north90/OpenSampler/Assembly_instructions/images/electronics_parts.jpg

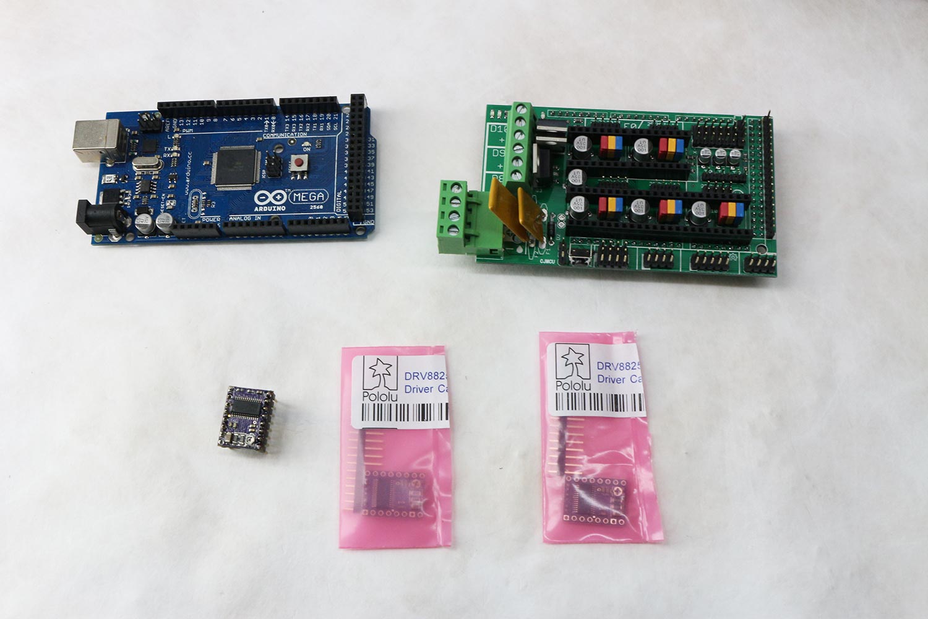
Assembly_instructions/images/electronics_parts.jpg
