north90/OpenSampler/README.md

OpenSampler
===========

Open Source Autosampler for use in laboratory analysis
