north90/OpenSampler/Software/Firmware_Arduino_mega/_20151002_Opensampler_V5_Sprinter/README.txt

Open and edit with arduino version 0.22 or 0.23
