north90/OpenSampler/Assembly_instructions/images/electronics_mounted.jpg

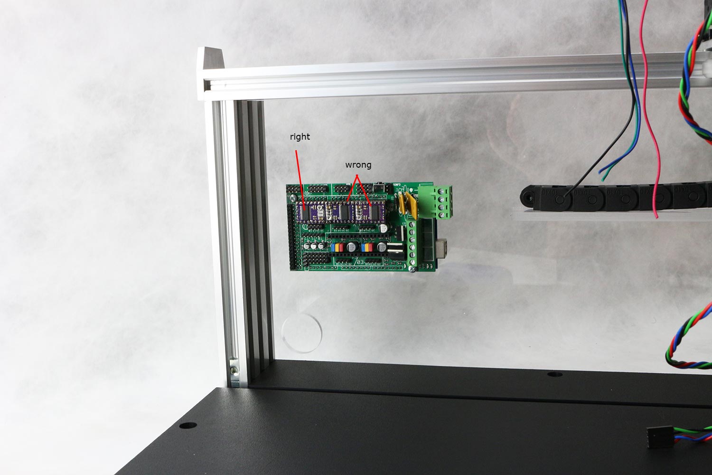
Assembly_instructions/images/electronics_mounted.jpg
