north90/OpenSampler/Photos/IMG_8499_small.jpg

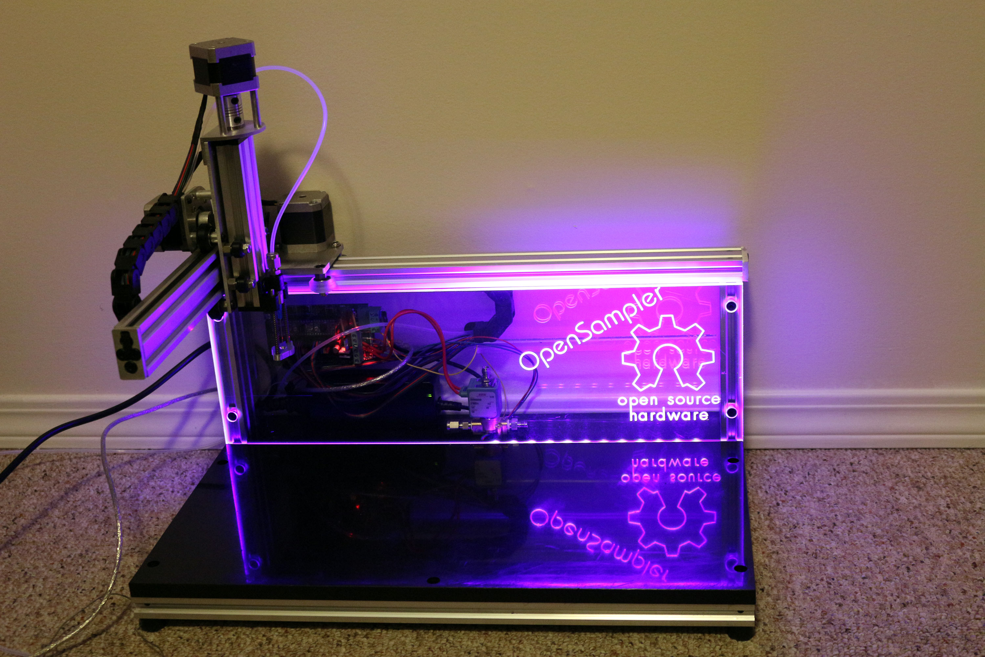
Photos/IMG_8499_small.jpg
