north90/OpenSampler/Photos/IMG_8510_small.jpg

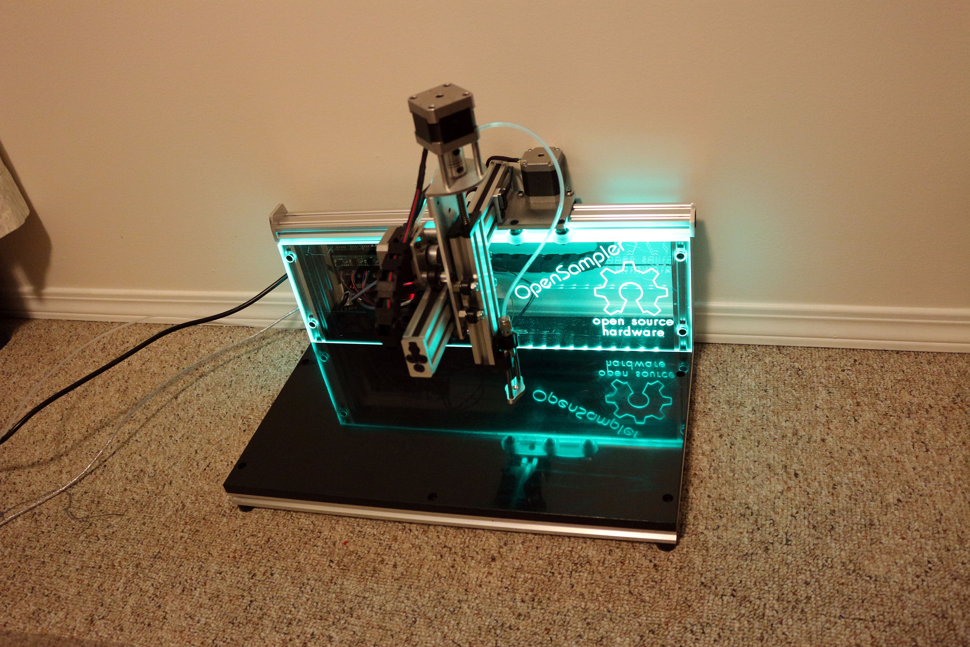
Photos/IMG_8510_small.jpg
