north90/OpenSampler/Photos/IMG_8513_small.jpg

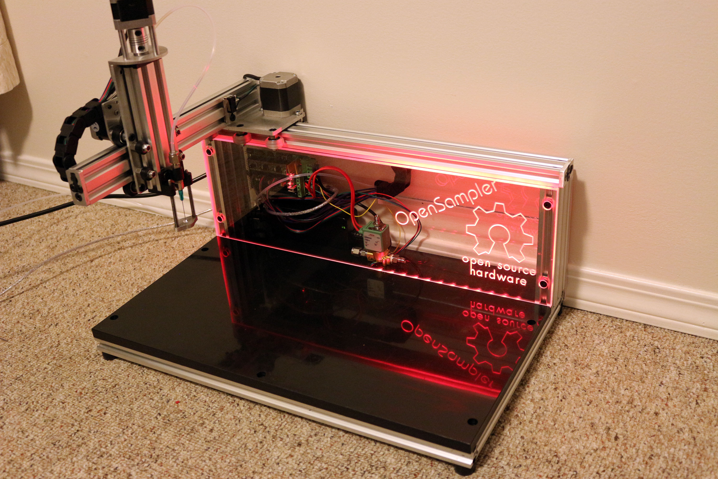
Photos/IMG_8513_small.jpg
