north90/OpenSampler/Required_parts_and_sources/README_OPENSAMPLER_PARTS.txt

In this folder there are printouts of shopping carts.
NOT all parts are needed in the QUANTITIES in the lists.
These lists are NOT 100% complete, but cover almost all parts.
These parts can be obtained at other sources that might be more economical.
