north90/OpenSampler/Required_parts_and_sources/20150505_mcmaster_partlist.pdf

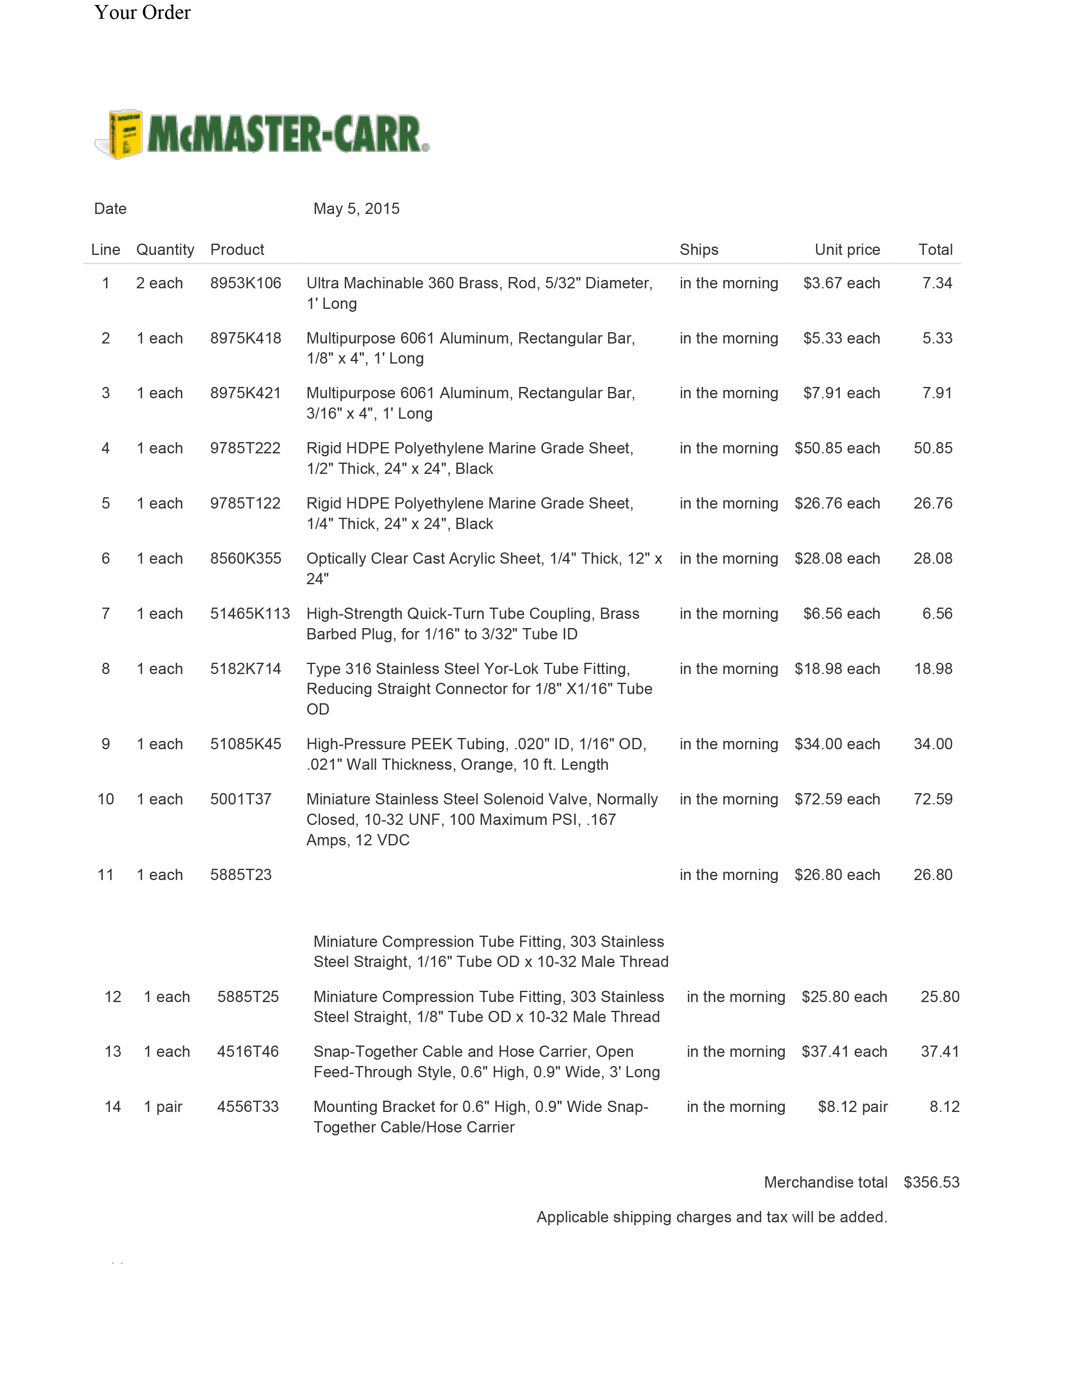
[picture p7: page 1]
