north90/OpenSampler/Required_parts_and_sources/20150505_openbuilds_partlist.pdf

sssttssstssststss sssstsssts ssssstststts tttttttttt

)ss)tssstt)))tsts)s) ss tttttt

et)s | eeetessesttstes s | tttstsstttst tssst

# tttstsstttst tssstt

sstttttsttsttsttttstsstttst ttssttssest ssttttsstsset

sssttsts)s | ytt | sts)tessts | sts)t ttsl

)sltttsstssst-

ssl
ss s t | ))tt t | )t)t
sst tts t ) | )t)t
ssst st
| s)test
) e | t | 4e)4

)sltttsstssst-

ssl
ss s t | ))tt t4 )t)t
sst tts t ) | )t)t
ssst st

)
s)test
) e) t | ) e)

)sltttsstssst-

ssl
ss s t | ))tt t) )t)t
sst tts t | ))t
ssst st

)
s)test
e | t | e
tss)ststlsst)tssssltst | )

s)test

e) t | )e )
slsstttstst)tssssltst | )

s)test

e | t | e
s | t) )))ttlt)stt)t s)st tetllsttht)4t ttts

s)test

)e | t | ) e
s | t ))t s)st ttslt | e | t | ) e
st tttsl | 4)e )

xsts)ststsssttst txt s

ssstst ttsl | 4)e )

## stsssttttsttesstss

ssttsststttssstttt slt)t
tttssstlstttststttttsstsststt tsstsslsttsstttsssttte

yssstlttstsssttt

ts sttsts

ttstsslss

tss sl

sstsss

xtst

ste

nstst

ds)tdsslsts

sst sttss

s)st sslsts

## ssss)tssstt ssstssststs

tttsttststtsssttssssttsst t st sstttsstssststs tsttssttsst sstttsstssstststttsststttsst t t slt)tststtlst.t.st.e

stt lstsxststss | t
et)s | tlt | msssssssstest ss) | mty | sexdtsssystestsstts
- t | t | 1 | 3
t | e// | - p | p pppp p pp p pp p/p p t | //////5/1/

sssttsts)s | ytt | sts)tessts | sts)t ttsl
| 4
| s)test

sttsst.st
ss s t sst ltst
ssst st

s)test

)e )t | e)

tlt)stt)tststsss
ss s t ) 4 t
ssst st

)
s)test
e 4t | e

xttsttssttststss
sst tts t ) 4 t
ssst st

s)test

e4)t | )e

st)testsslststss)stt
sst tts t )) t tettst
ssst st

)
s)test
)e | t | )e

st)testsslststss)stt
sst tts t ) )) t tettst
ssst st

s)test

e4 t | ) e )
dtttelstststst ))ttstsstttt)stsssststss) | )

s)test

e 4t | e 4
sstdttst) | test.)
ss s t t t
ssst st

s)test

e | t | ))e
st tttsl | 4)e )

xsts)ststsssttst txt s

ssstst ttsl | 4)e )
- t | t | 5 | 3

hhttsthh
tsst.ttttt)stst)tltstlstsssssssss

slst.tsssstttt.ssttsstttst t

sssttsts)s | ytt | sts)tessts | sts)t ttsl

st)testsslststss)stt
sst tts t )) t) tettst
ssst st
| )
| s)test
e | t | e
stt.sttessststss)stt t) | test.)
sst tts t )))t
ssst st

)
s)test
e4)t | e4)
stt.sttessststss)stt t) | test.)
sst tts t | ))t
ssst st

)
s)test
e4)t | e4)

tllsttssstts
ss s t ))t
ssst st

s)test

e )t | e
st tttsl | 4)e )

xsts)ststsssttst txt s

ssstst ttsl | 4)e )

# sttttttstss

sstttttsseststtttttttttss tsttsststtstttsst t t slt)tststtlst.t.st.e

tttstmsssttds)s | tttstx)sslttssssss

# ststtds)slsttss

ststttslsstst

# ststttstsstss

ststttslsststsstest!

)hslttt4 ))t t4 ))

ststttslsstesstst ssttsts

tttsst tststslstttttts!

shtss)t slssss

tllttsstsstssststtstytstttss stt | ) tststttslsstessttsttssetssts)stt tessestttetlstt
- t | t | 3 | 3
