north90/OpenSampler/Assembly_instructions/images/frame_parts.jpg

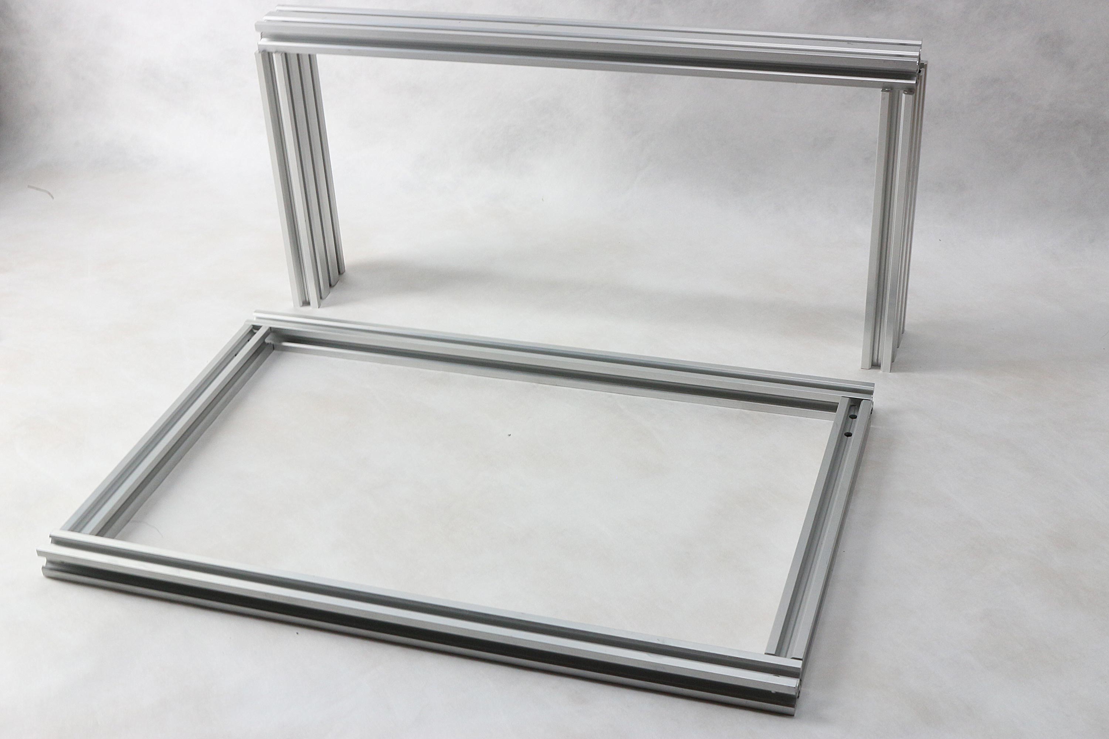
Assembly_instructions/images/frame_parts.jpg
