north90/OpenSampler/Assembly_instructions/images/y_endstop_parts.jpg

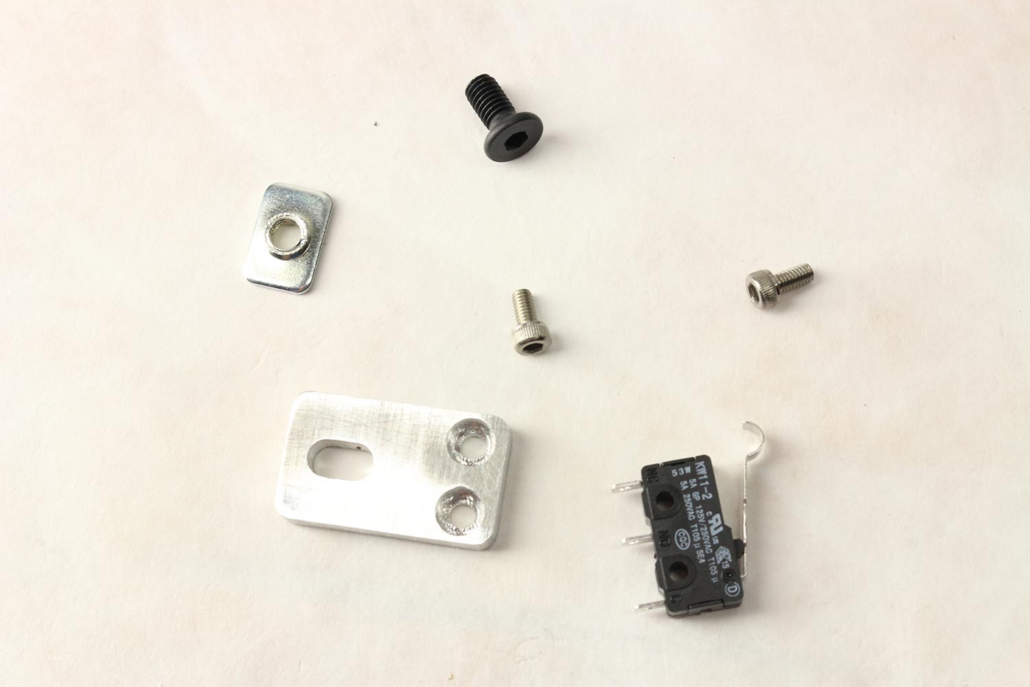
Assembly_instructions/images/y_endstop_parts.jpg
