north90/OpenSampler/Assembly_instructions/images/z_parts.jpg

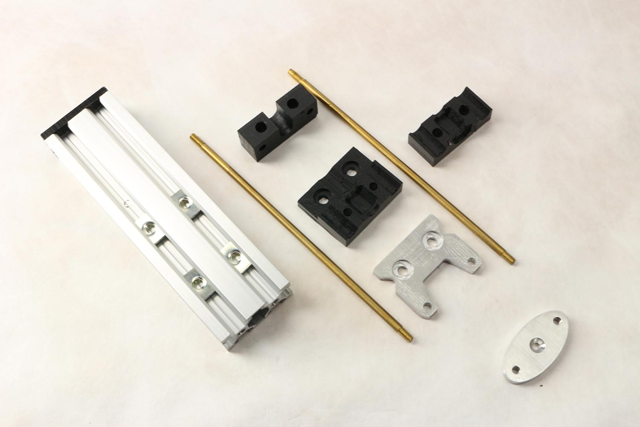
Assembly_instructions/images/z_parts.jpg
