north90/OpenSampler/Mechanical_design/INDIVIDUAL_PARTS_2D/20150915_3X_16mm_40tube_tray_v0p0.dxf

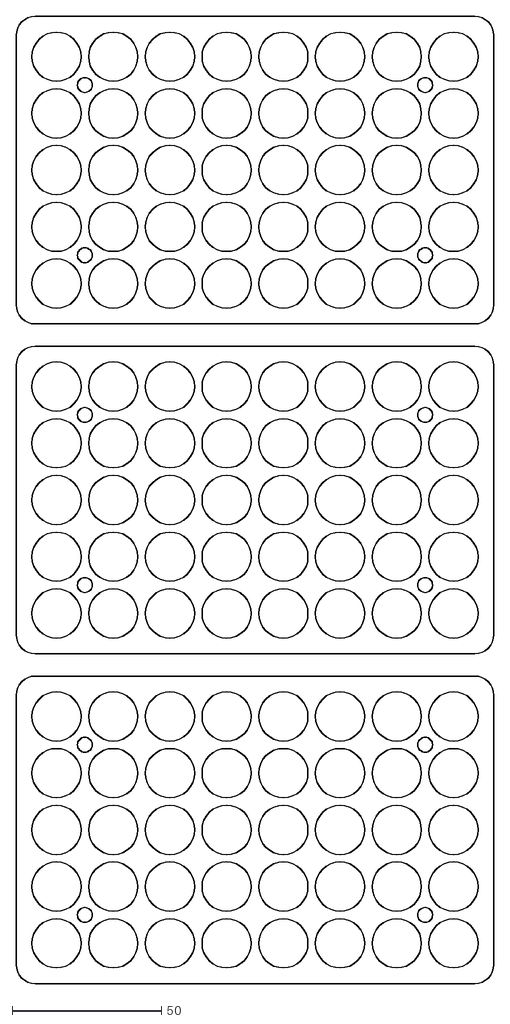
[picture p11: CAD file, 2017-06-14]
Mechanical_design/INDIVIDUAL_PARTS_2D/20150915_3X_16mm_40tube_tray_v0p0.dxf
160.0 x 324.0
