north90/OpenSampler/Mechanical_design/INDIVIDUAL_PARTS_2D/20150915_HDPE_backplate.dxf

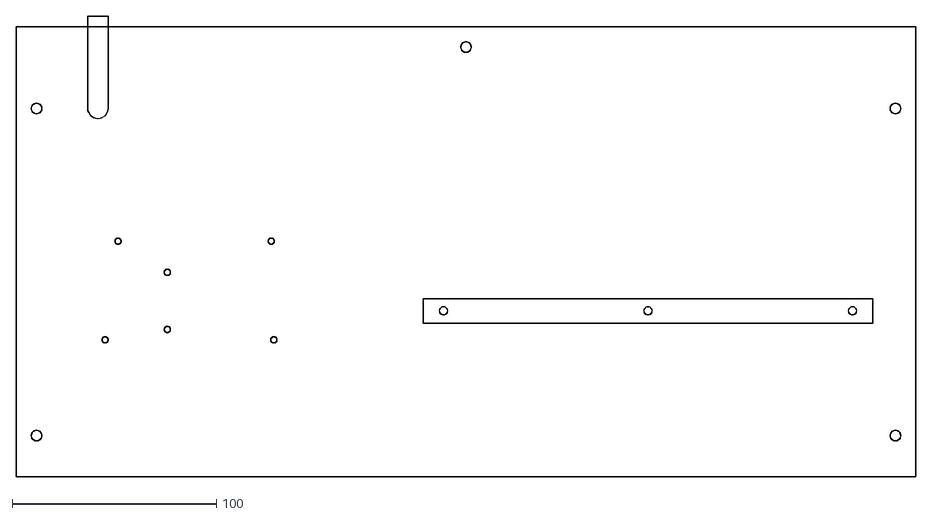
[picture p12: CAD file, 2017-06-14]
Mechanical_design/INDIVIDUAL_PARTS_2D/20150915_HDPE_backplate.dxf
440.0 x 225.0
