north90/OpenSampler/Mechanical_design/INDIVIDUAL_PARTS_2D/20150609_spring_plate.dxf

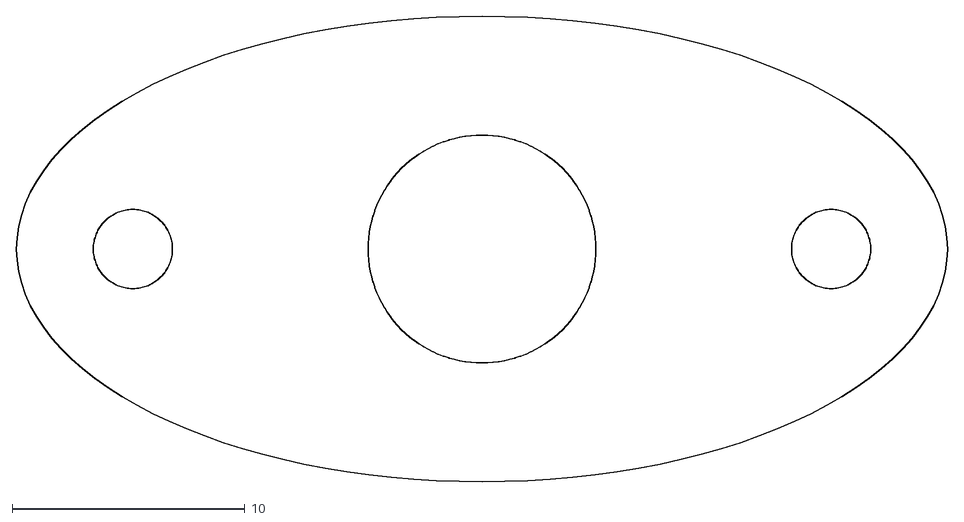
[picture p13: CAD file, 2017-06-14]
Mechanical_design/INDIVIDUAL_PARTS_2D/20150609_spring_plate.dxf
40.0 x 20.0
