north90/OpenSampler/Mechanical_design/INDIVIDUAL_PARTS_2D/20150609_spring_support_plate_bottom.dxf

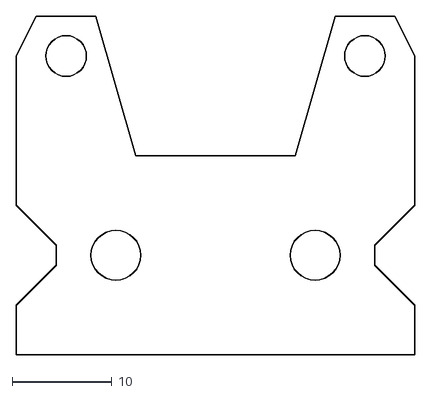
[picture p14: CAD file, 2017-06-14]
Mechanical_design/INDIVIDUAL_PARTS_2D/20150609_spring_support_plate_bottom.dxf
40.0 x 34.0
