north90/OpenSampler/Mechanical_design/INDIVIDUAL_PARTS_2D/20150602_frontplate.dxf

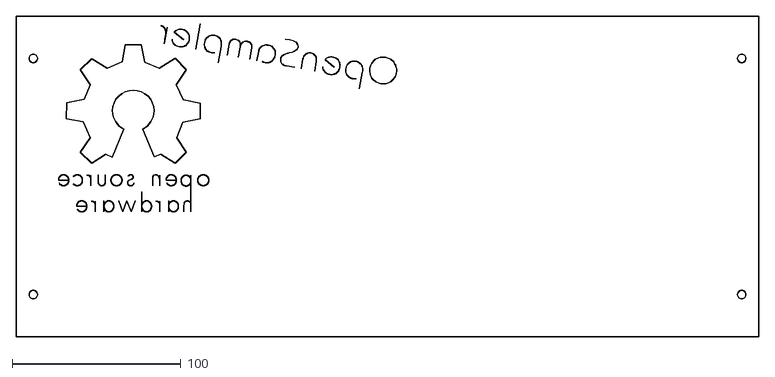
[picture p15: CAD file, 2017-06-14]
Mechanical_design/INDIVIDUAL_PARTS_2D/20150602_frontplate.dxf
440.0 x 190.0
