north90/OpenSampler/Mechanical_design/INDIVIDUAL_PARTS_2D/20150610_z_motor_plate_ACME_top-cut.dxf

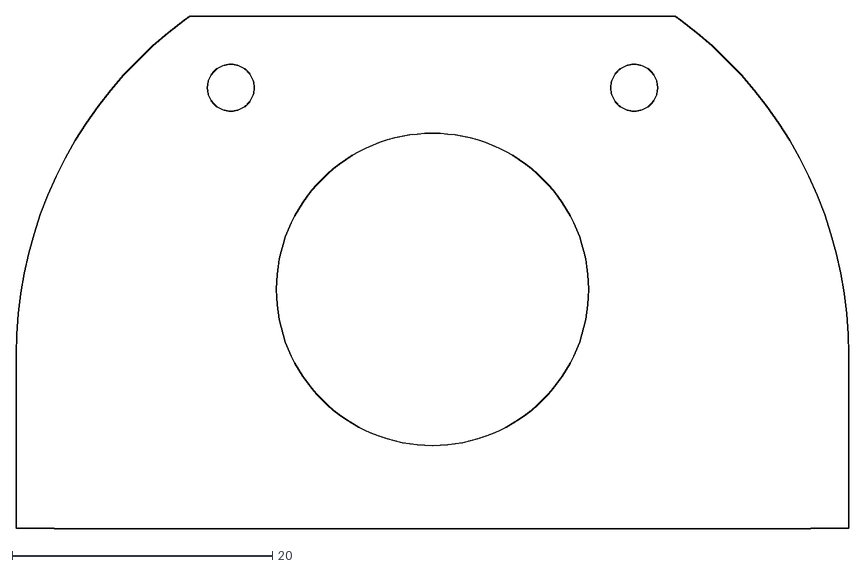
[picture p16: CAD file, 2017-06-14]
Mechanical_design/INDIVIDUAL_PARTS_2D/20150610_z_motor_plate_ACME_top-cut.dxf
64.0 x 39.4
