north90/OpenSampler/Mechanical_design/INDIVIDUAL_PARTS_2D/20150608_y_plate_top.dxf

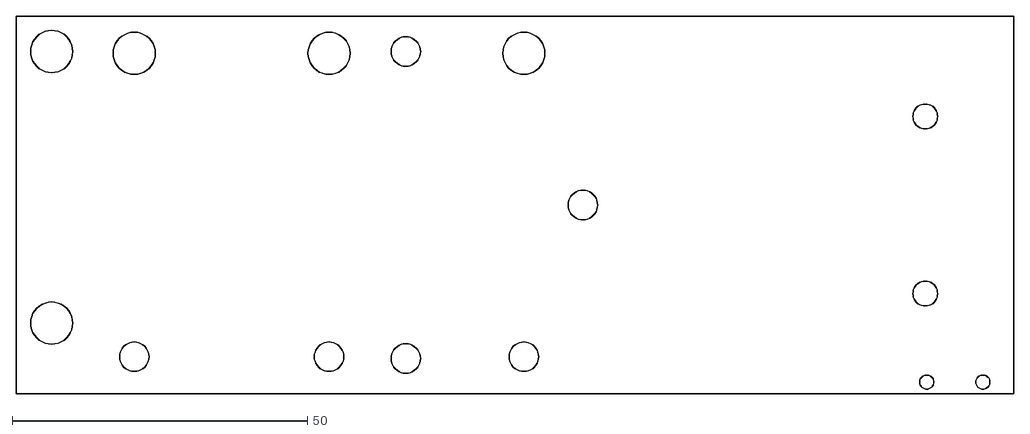
[picture p17: CAD file, 2017-06-14]
Mechanical_design/INDIVIDUAL_PARTS_2D/20150608_y_plate_top.dxf
169.0 x 64.0
