north90/OpenSampler/Mechanical_design/INDIVIDUAL_PARTS_2D/20150609_needle_mount_bottom.stl

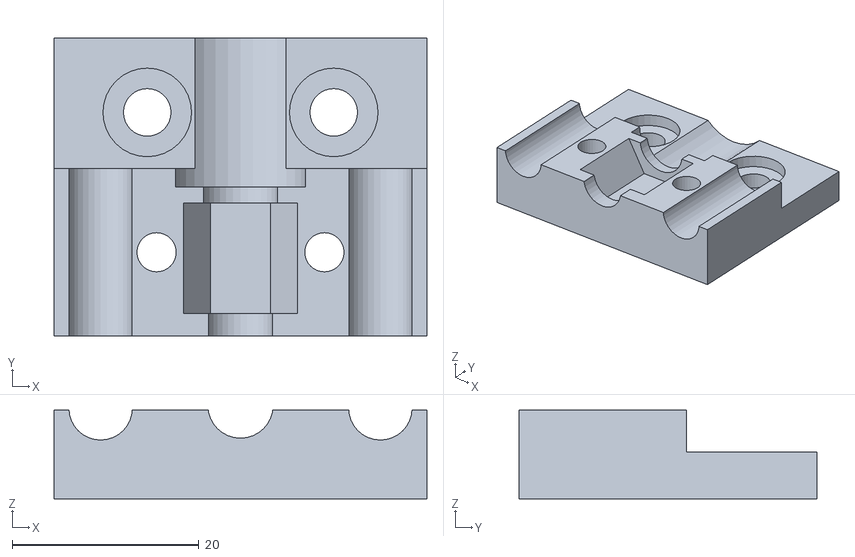
[picture p18: CAD file, 2017-06-14]
Mechanical_design/INDIVIDUAL_PARTS_2D/20150609_needle_mount_bottom.stl
40.0 x 32.0 x 9.50
