north90/OpenSampler/Mechanical_design/INDIVIDUAL_PARTS_2D/20150917_solenoid_plate_5mm.dxf

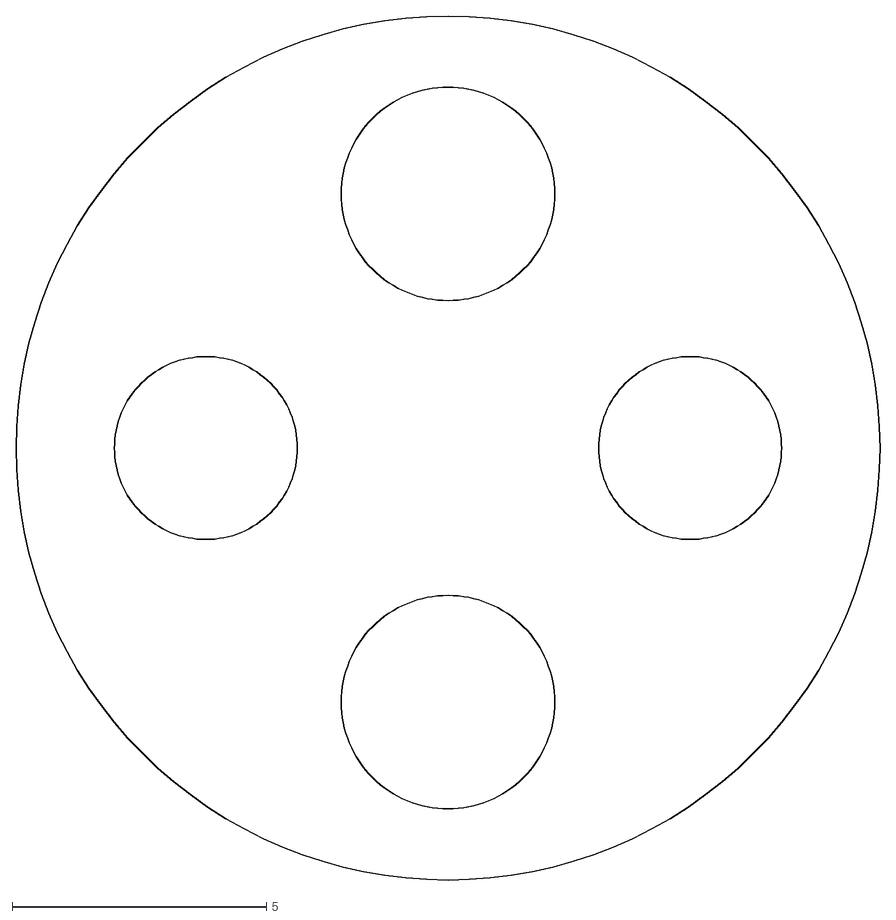
[picture p19: CAD file, 2017-06-14]
Mechanical_design/INDIVIDUAL_PARTS_2D/20150917_solenoid_plate_5mm.dxf
17.0 x 17.0
