north90/OpenSampler/Mechanical_design/INDIVIDUAL_PARTS_2D/20150609_needle_mount_top.stl

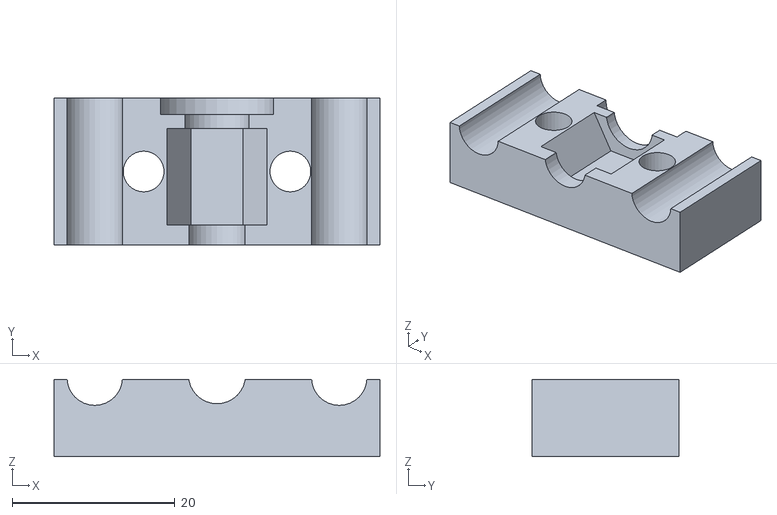
[picture p20: CAD file, 2017-06-14]
Mechanical_design/INDIVIDUAL_PARTS_2D/20150609_needle_mount_top.stl
40.0 x 18.0 x 9.50
