north90/OpenSampler/Mechanical_design/INDIVIDUAL_PARTS_2D/20150706_x_cart.dxf

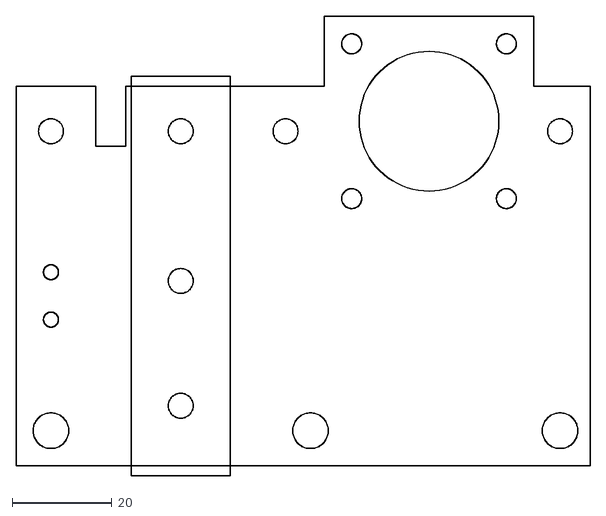
[picture p21: CAD file, 2017-06-14]
Mechanical_design/INDIVIDUAL_PARTS_2D/20150706_x_cart.dxf
115.0 x 92.0
