north90/OpenSampler/Mechanical_design/INDIVIDUAL_PARTS_2D/20150706_1x2_belt_endplate.dxf

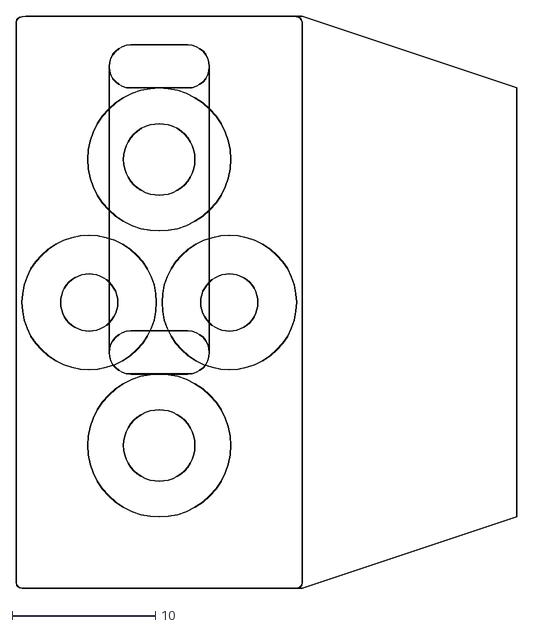
[picture p22: CAD file, 2017-06-14]
Mechanical_design/INDIVIDUAL_PARTS_2D/20150706_1x2_belt_endplate.dxf
35.0 x 40.0
