north90/OpenSampler/Mechanical_design/INDIVIDUAL_PARTS_2D/20150608_z_motor_plate_side-cut.dxf

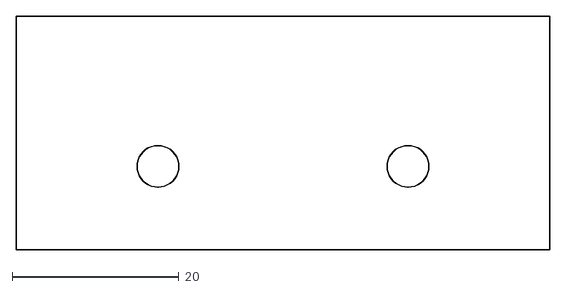
[picture p23: CAD file, 2017-06-14]
Mechanical_design/INDIVIDUAL_PARTS_2D/20150608_z_motor_plate_side-cut.dxf
64.0 x 28.0
