north90/OpenSampler/Mechanical_design/INDIVIDUAL_PARTS_2D/20150609_spring_support_plate_top.dxf

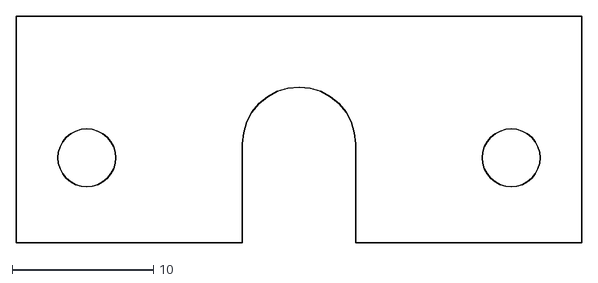
[picture p25: CAD file, 2017-06-14]
Mechanical_design/INDIVIDUAL_PARTS_2D/20150609_spring_support_plate_top.dxf
40.0 x 16.0
