north90/OpenSampler/Mechanical_design/INDIVIDUAL_PARTS_2D/20150608_z_motor_plate_top-cut.dxf

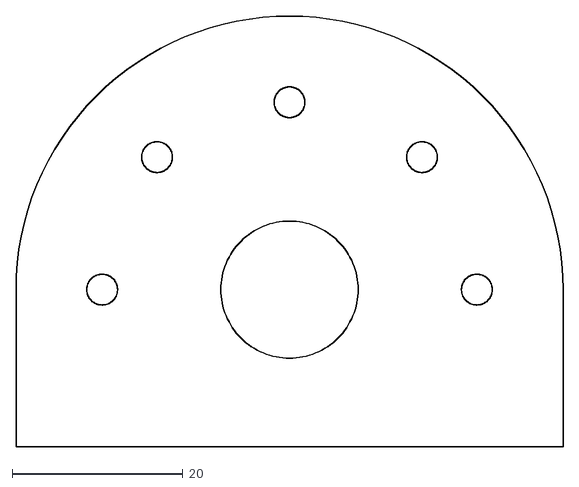
[picture p26: CAD file, 2017-06-14]
Mechanical_design/INDIVIDUAL_PARTS_2D/20150608_z_motor_plate_top-cut.dxf
64.0 x 50.4
