north90/OpenSampler/Mechanical_design/INDIVIDUAL_PARTS_2D/20150613_16mm_tube_tray_v0p0.dxf

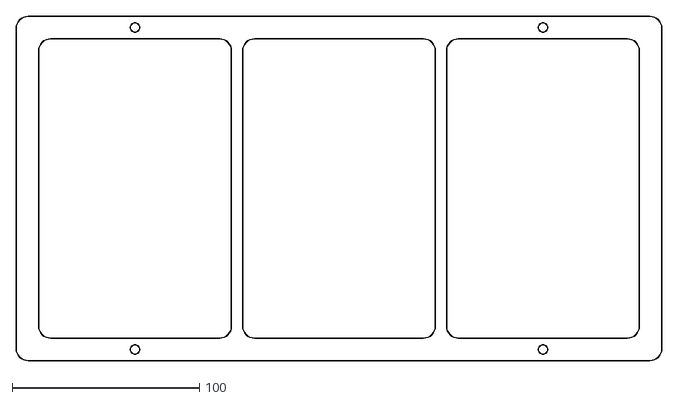
[picture p27: CAD file, 2017-06-14]
Mechanical_design/INDIVIDUAL_PARTS_2D/20150613_16mm_tube_tray_v0p0.dxf
345.0 x 184.0
