north90/OpenSampler/Mechanical_design/INDIVIDUAL_PARTS_2D/20150706_y_motor_plate.dxf

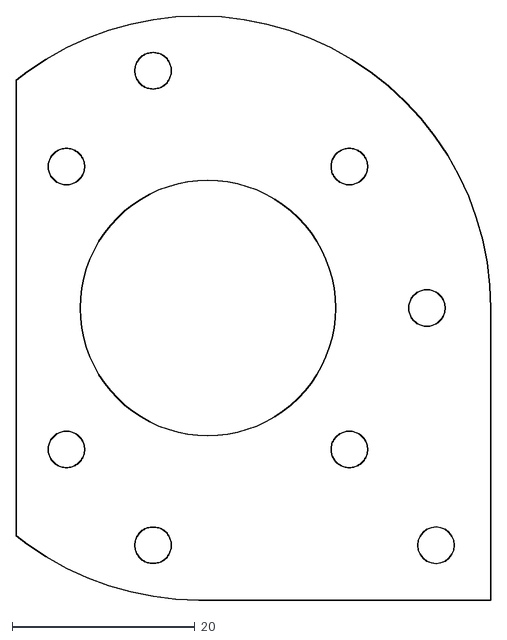
[picture p28: CAD file, 2017-06-14]
Mechanical_design/INDIVIDUAL_PARTS_2D/20150706_y_motor_plate.dxf
52.0 x 64.0
