north90/OpenSampler/(list of files, cad)

Other CAD files:
Mechanical_design/OpenSampler_v5_PARTS_v0p0.scad
Mechanical_design/OpenSampler_v5_v0p0.scad
Mechanical_design/INDIVIDUAL_PARTS_2D/20150613_16mm_tube_tray_v0p0.scad
Mechanical_design/INDIVIDUAL_PARTS_2D/20150610_z_motor_plate_ACME_side-cut.dxf
Mechanical_design/INDIVIDUAL_PARTS_2D/20150917_bottomplate_top.dxf
Mechanical_design/INDIVIDUAL_PARTS_2D/20150920_Y-endstop-plate_5mm.dxf
Mechanical_design/OpenSampler_v4_config_v0p0.scad
