north90/OpenSampler/Assembly_instructions/images/back_plate.jpg

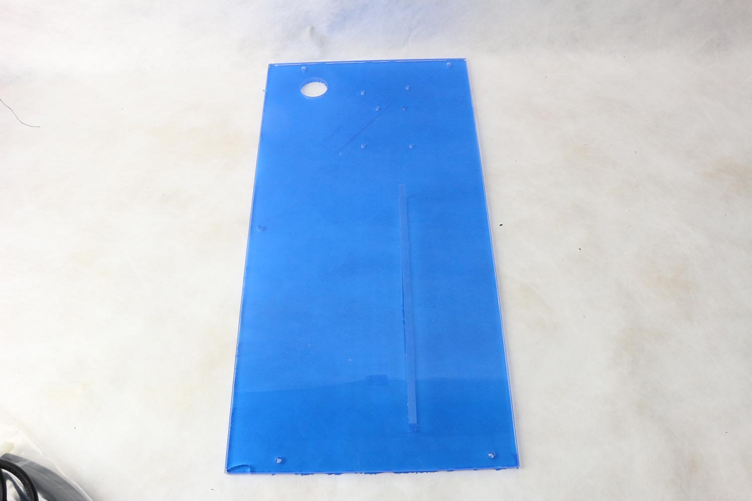
Assembly_instructions/images/back_plate.jpg
