north90/OpenSampler/Assembly_instructions/images/base_plate.jpg

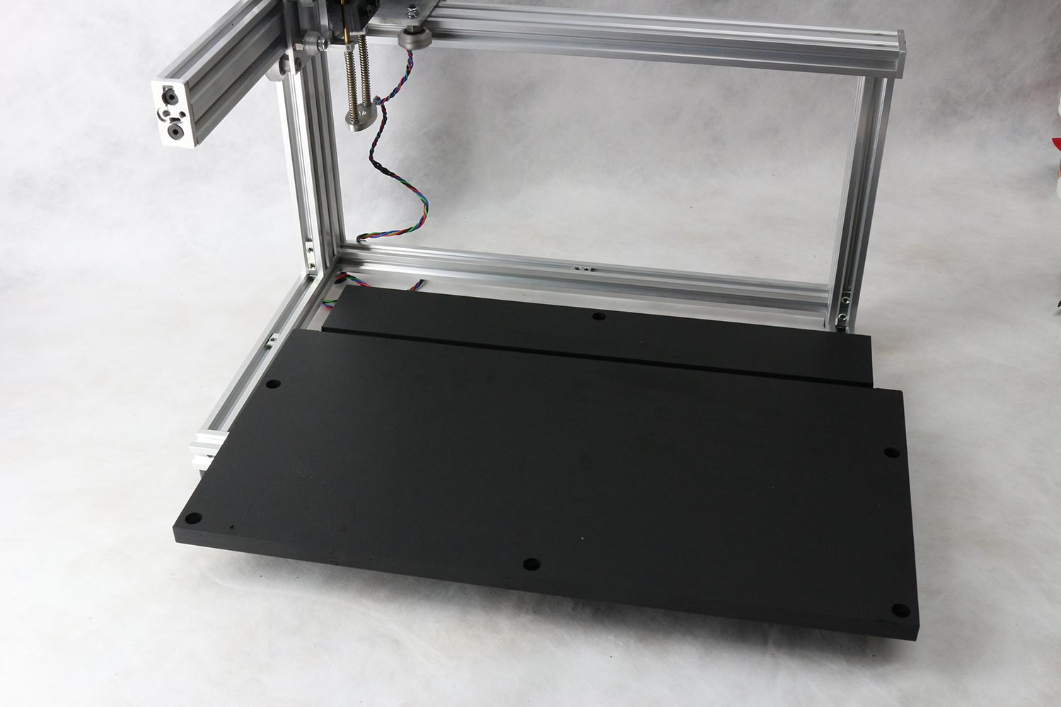
Assembly_instructions/images/base_plate.jpg
