north90/OpenSampler/Assembly_instructions/images/belt_end_plate_x_4.jpg

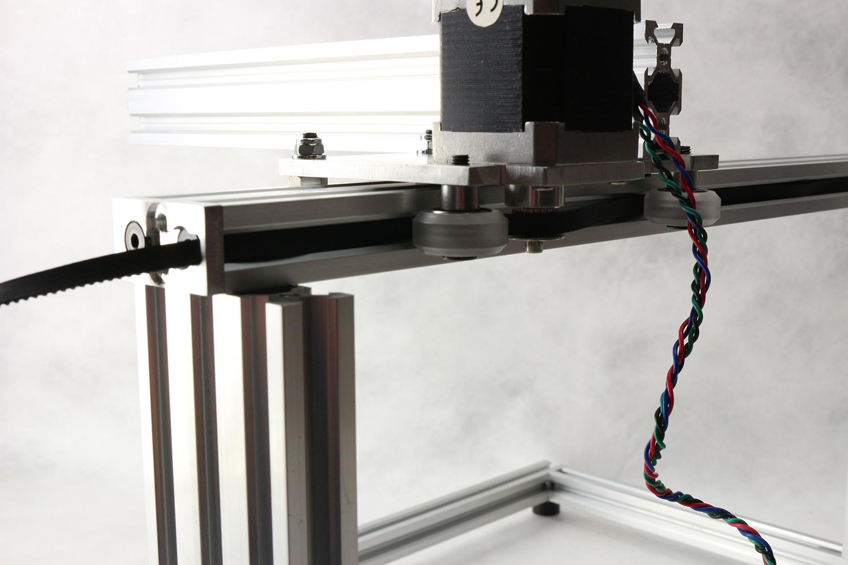
Assembly_instructions/images/belt_end_plate_x_4.jpg
