north90/OpenSampler/Assembly_instructions/images/belts_detail.jpg

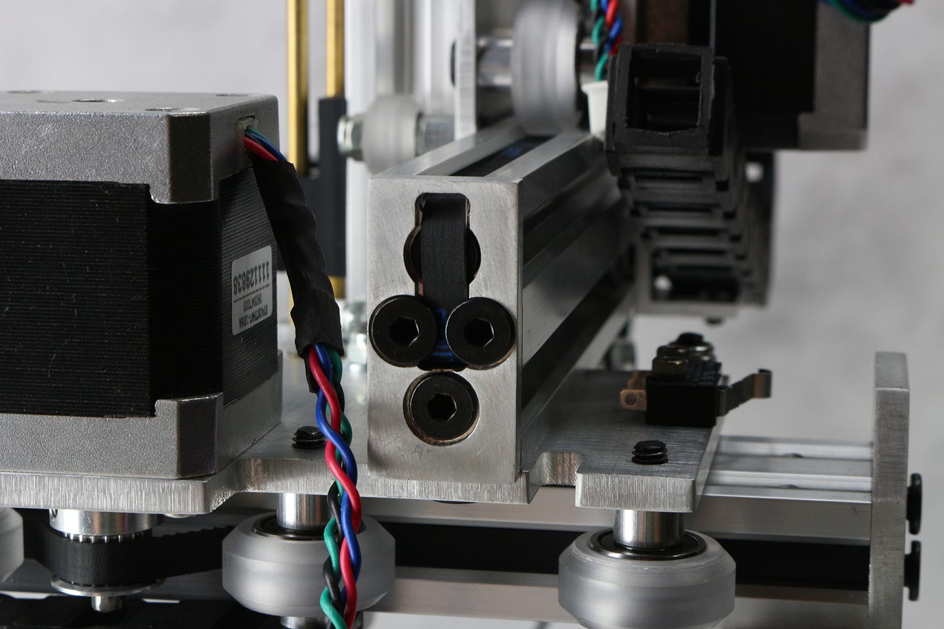
Assembly_instructions/images/belts_detail.jpg
