north90/OpenSampler/Assembly_instructions/images/endstop_hookup.jpg

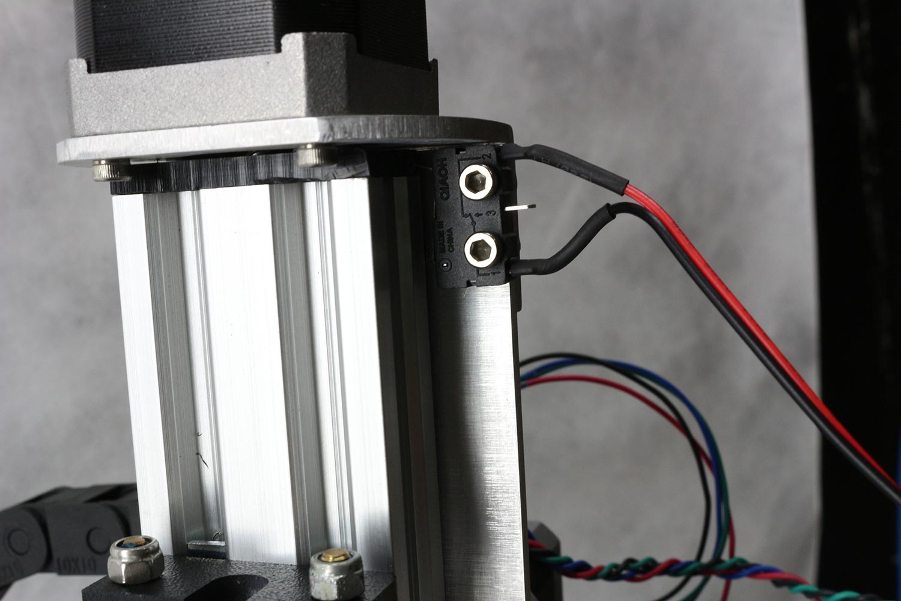
Assembly_instructions/images/endstop_hookup.jpg
