north90/OpenSampler/Assembly_instructions/images/feet1.jpg

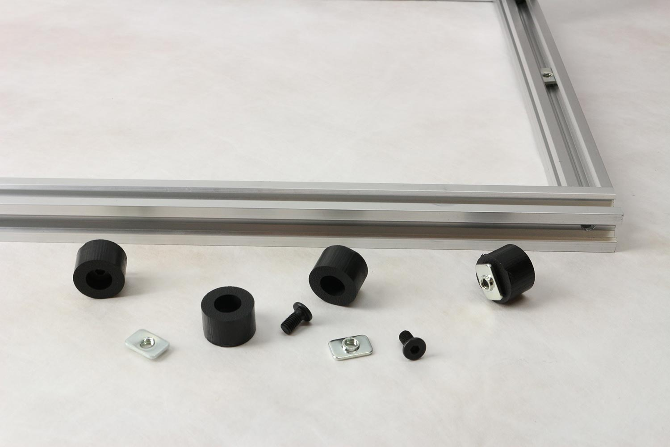
Assembly_instructions/images/feet1.jpg
