north90/OpenSampler/Assembly_instructions/images/mechanical_assembly.jpg

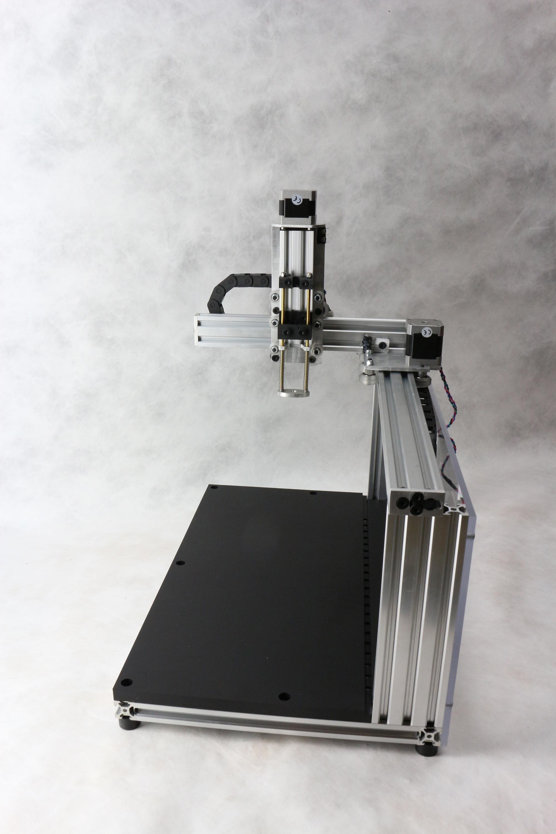
Assembly_instructions/images/mechanical_assembly.jpg
