north90/OpenSampler/Assembly_instructions/images/ramps_bottom.jpg

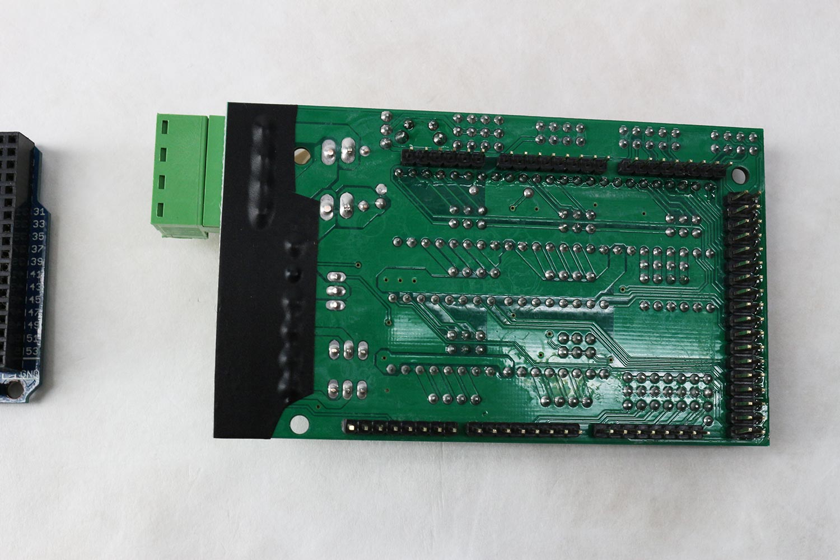
Assembly_instructions/images/ramps_bottom.jpg
