north90/OpenSampler/Assembly_instructions/images/t-connect.jpg

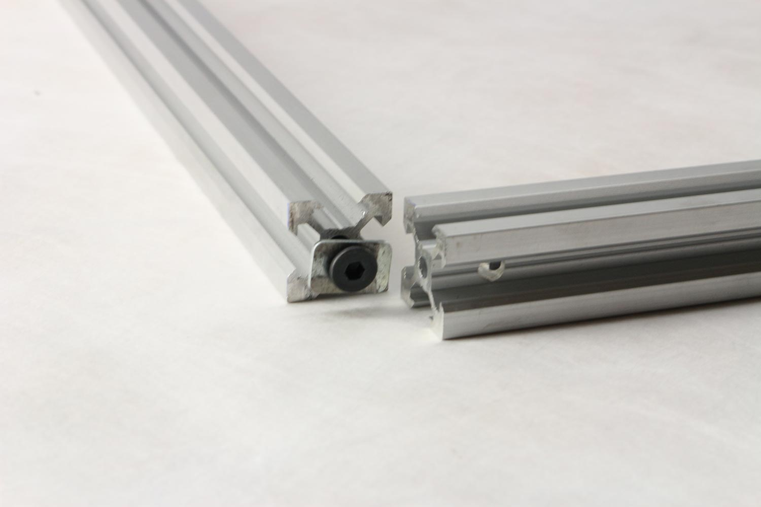
Assembly_instructions/images/t-connect.jpg
