north90/OpenSampler/Assembly_instructions/images/T-connectors.jpg

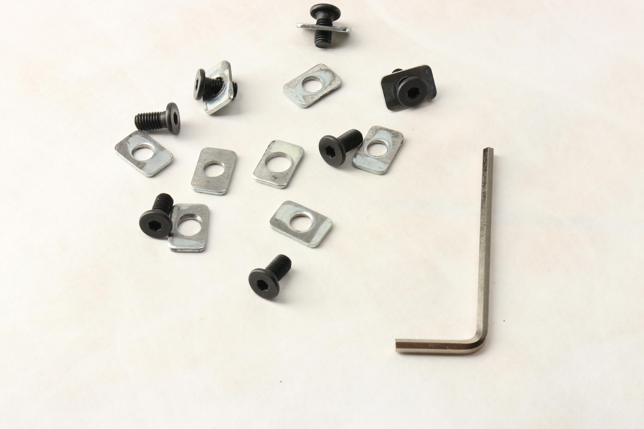
Assembly_instructions/images/T-connectors.jpg
