north90/OpenSampler/Assembly_instructions/images/vert_hor_connect2.jpg

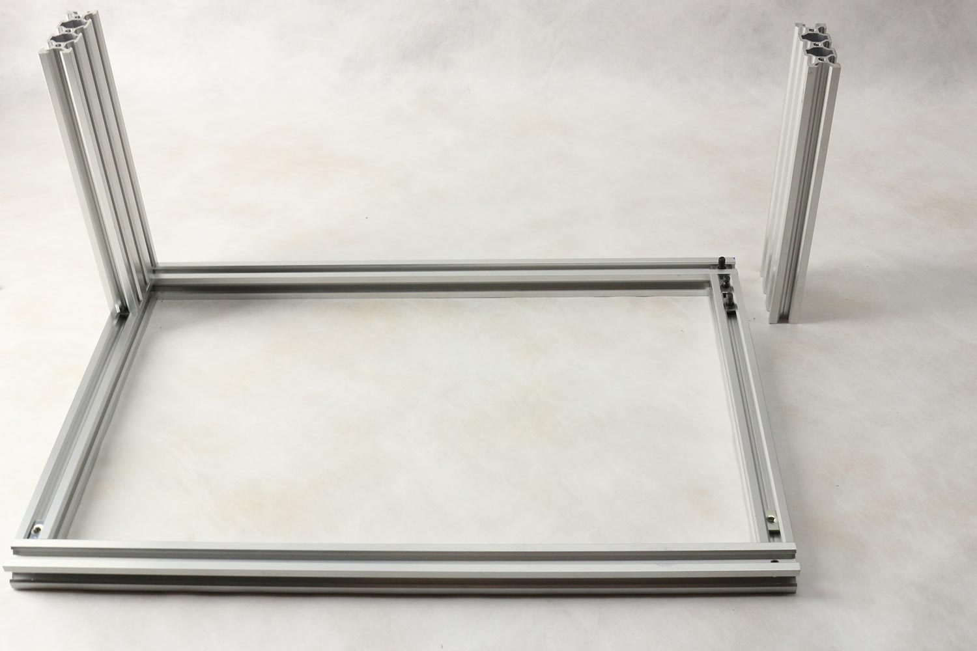
Assembly_instructions/images/vert_hor_connect2.jpg
