north90/OpenSampler/Assembly_instructions/images/vert_hor_connect.jpg

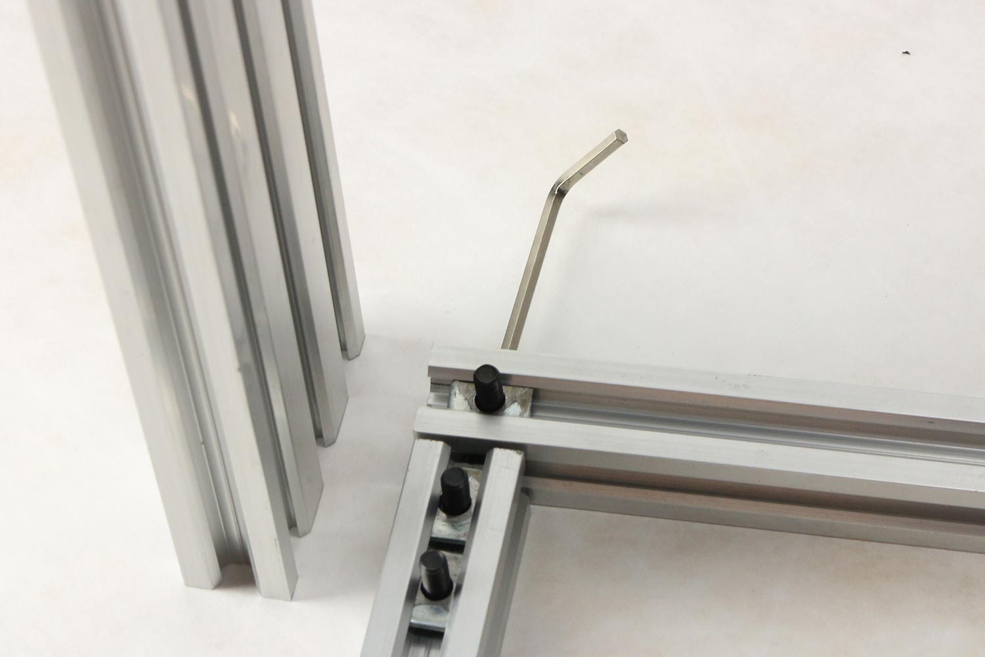
Assembly_instructions/images/vert_hor_connect.jpg
