north90/OpenSampler/Assembly_instructions/images/x-bar-connect.jpg

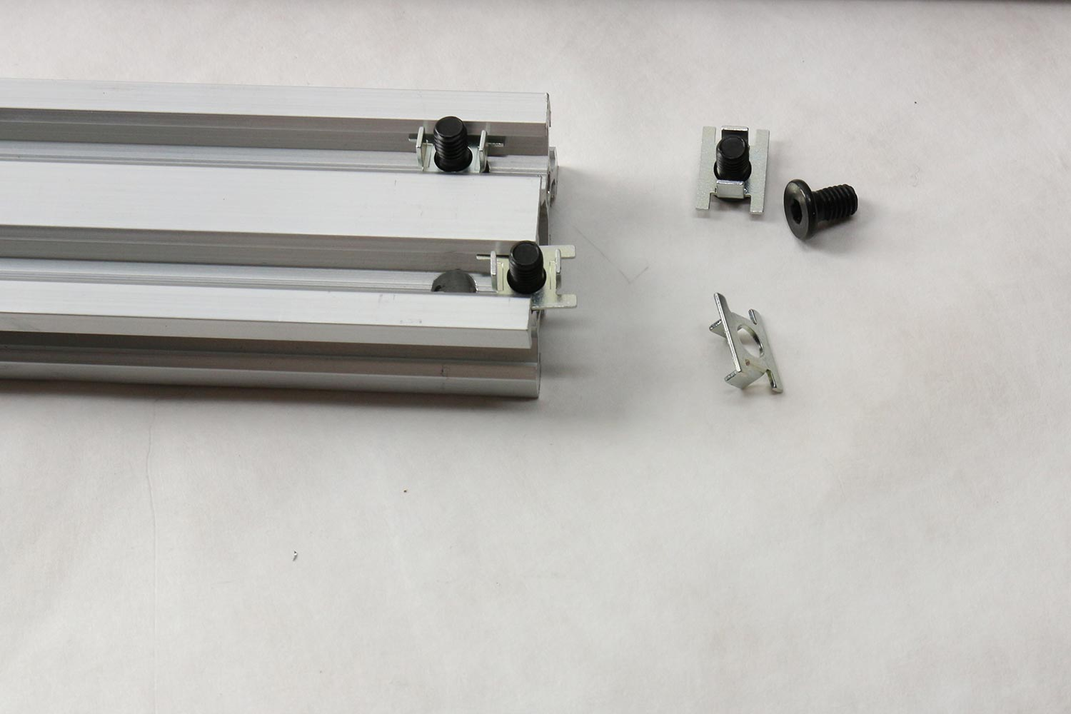
Assembly_instructions/images/x-bar-connect.jpg
