north90/OpenSampler/Assembly_instructions/images/x-bar-connect_2.jpg

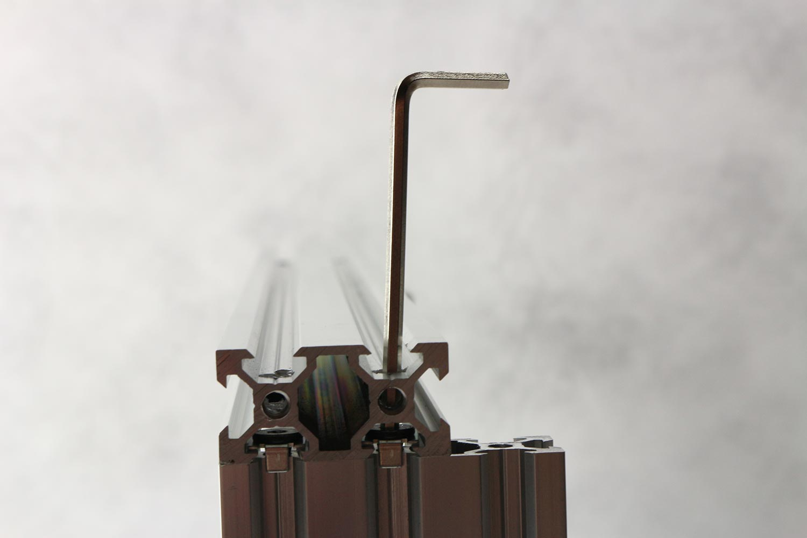
Assembly_instructions/images/x-bar-connect_2.jpg
