north90/OpenSampler/Assembly_instructions/images/x_cable_carrier_1.jpg

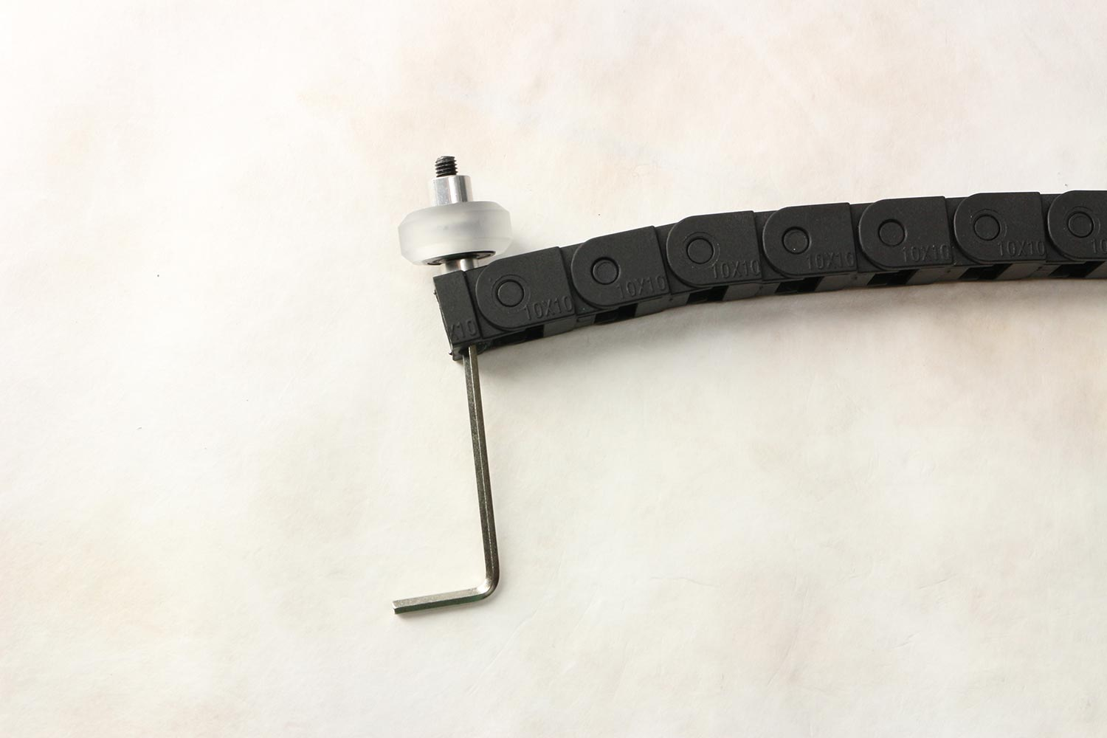
Assembly_instructions/images/x_cable_carrier_1.jpg
