north90/OpenSampler/Assembly_instructions/images/x_cable_carrier_2.jpg

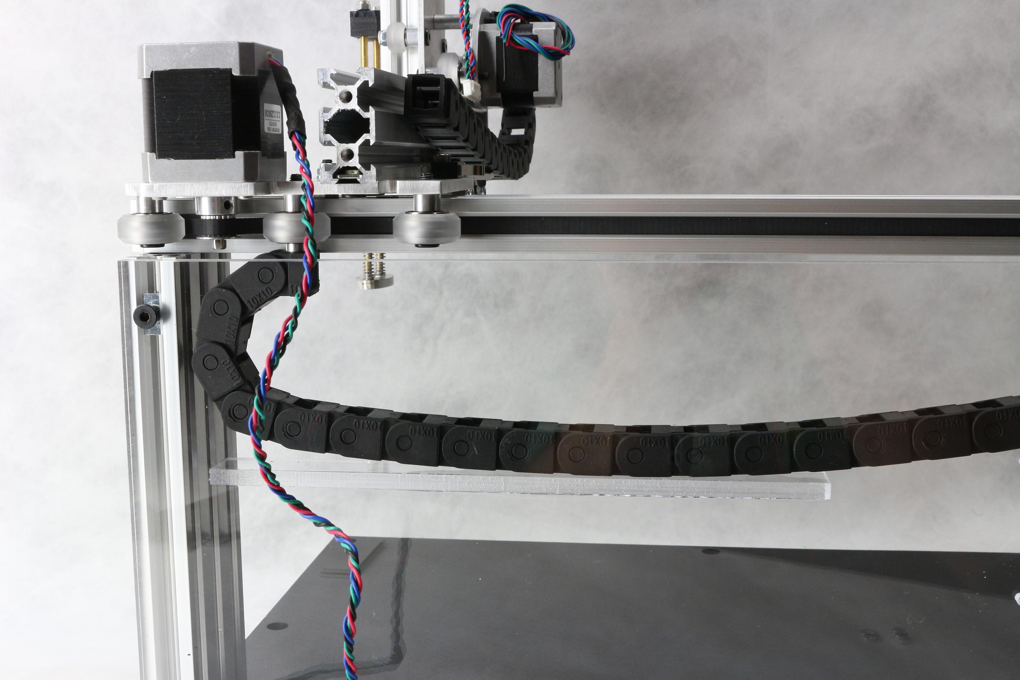
Assembly_instructions/images/x_cable_carrier_2.jpg
