north90/OpenSampler/Assembly_instructions/images/x_cable_management.jpg

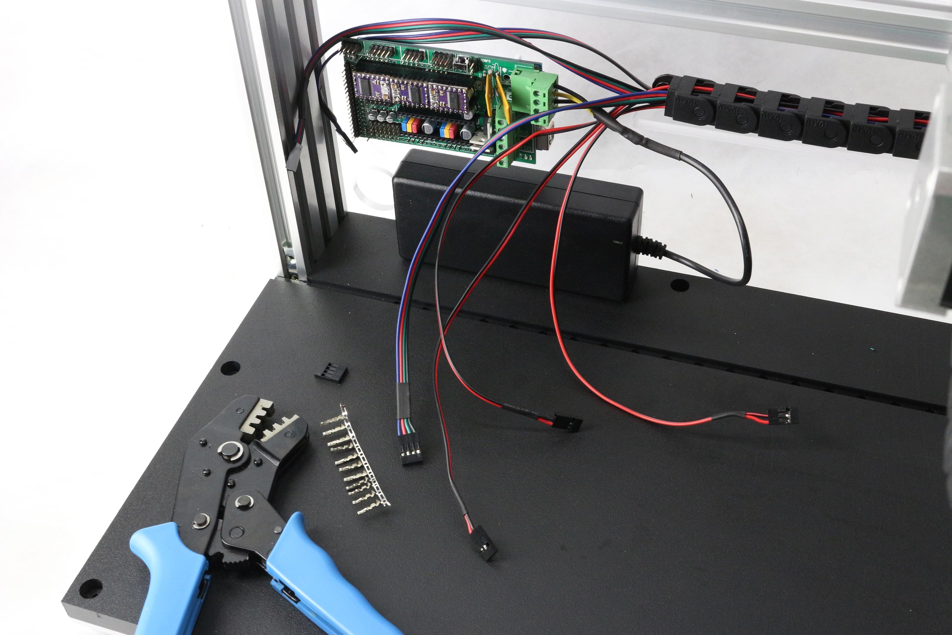
Assembly_instructions/images/x_cable_management.jpg
