north90/OpenSampler/Assembly_instructions/images/x_endstop.jpg

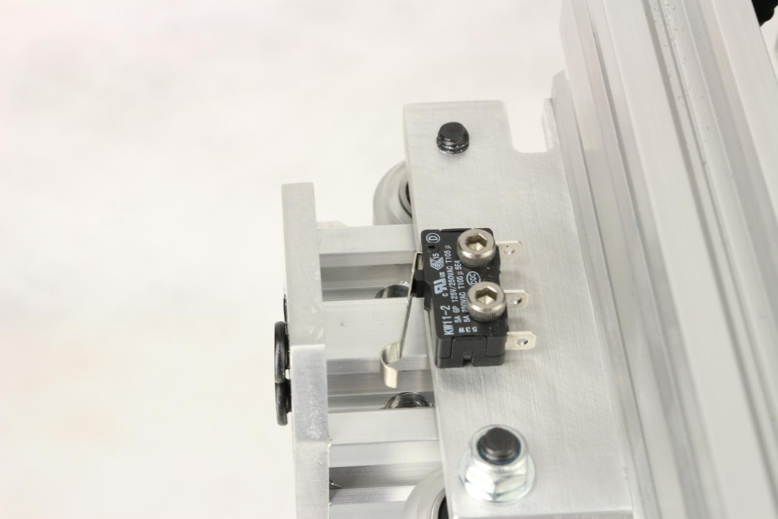
Assembly_instructions/images/x_endstop.jpg
