north90/OpenSampler/Assembly_instructions/images/x_plate1.jpg

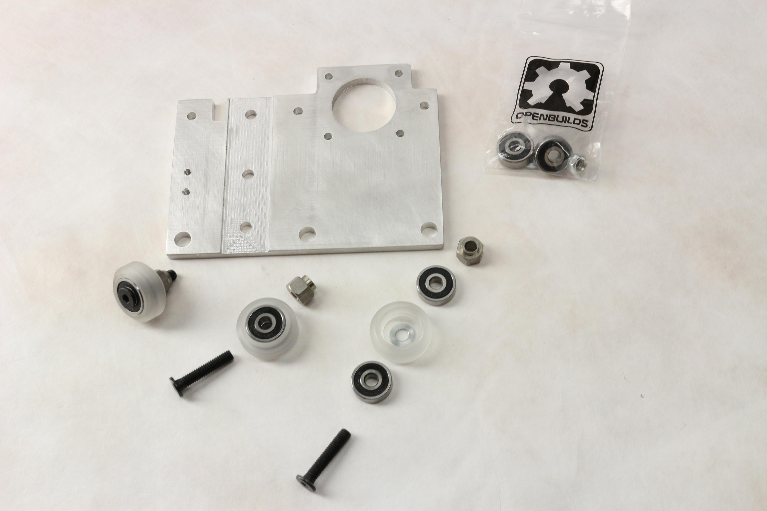
Assembly_instructions/images/x_plate1.jpg
