north90/OpenSampler/Assembly_instructions/images/x_plate2.jpg

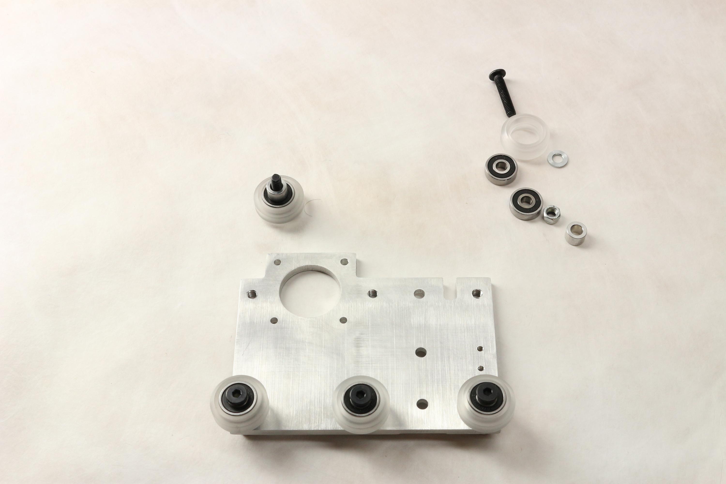
Assembly_instructions/images/x_plate2.jpg
