north90/OpenSampler/Assembly_instructions/images/x_plate3.jpg

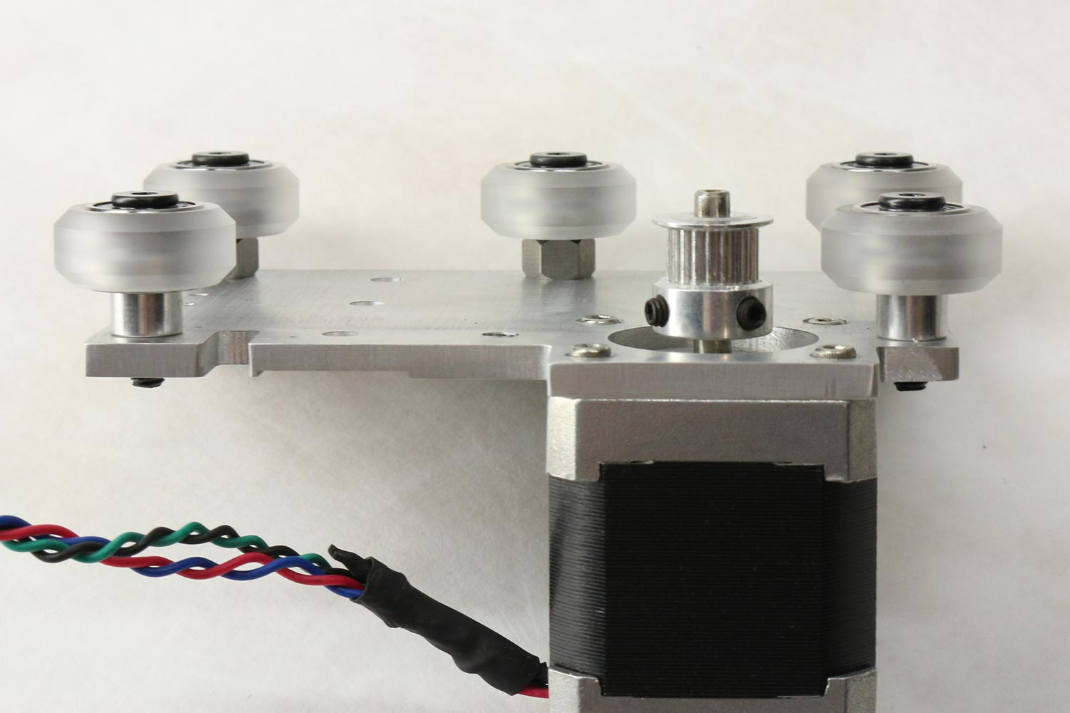
Assembly_instructions/images/x_plate3.jpg
