north90/OpenSampler/Assembly_instructions/images/x_plate5.jpg

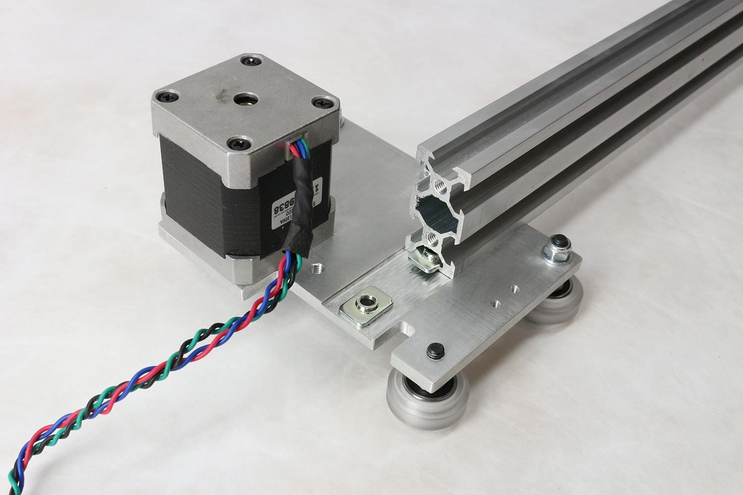
Assembly_instructions/images/x_plate5.jpg
