north90/OpenSampler/Assembly_instructions/images/y_belt.jpg

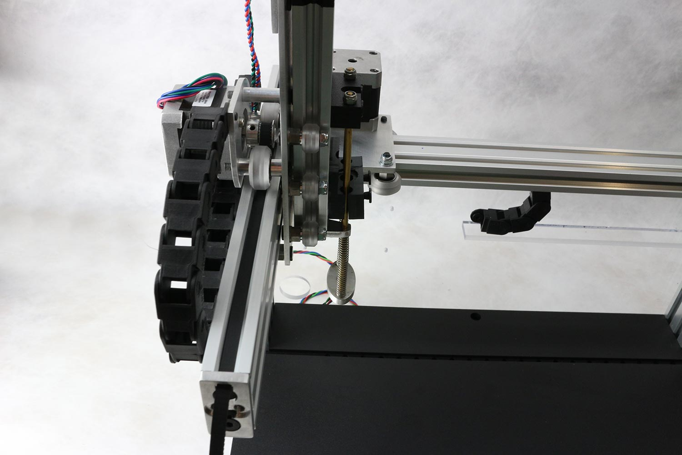
Assembly_instructions/images/y_belt.jpg
