north90/OpenSampler/Assembly_instructions/images/y_cable_carrier.jpg

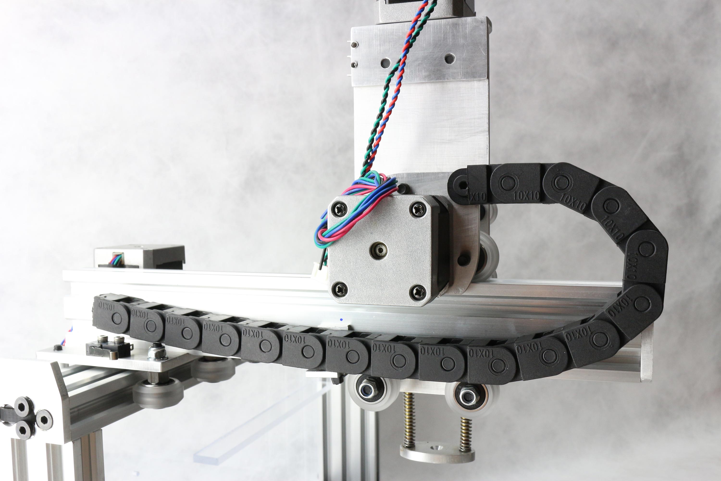
Assembly_instructions/images/y_cable_carrier.jpg
