north90/OpenSampler/Assembly_instructions/images/y_cable_management.jpg

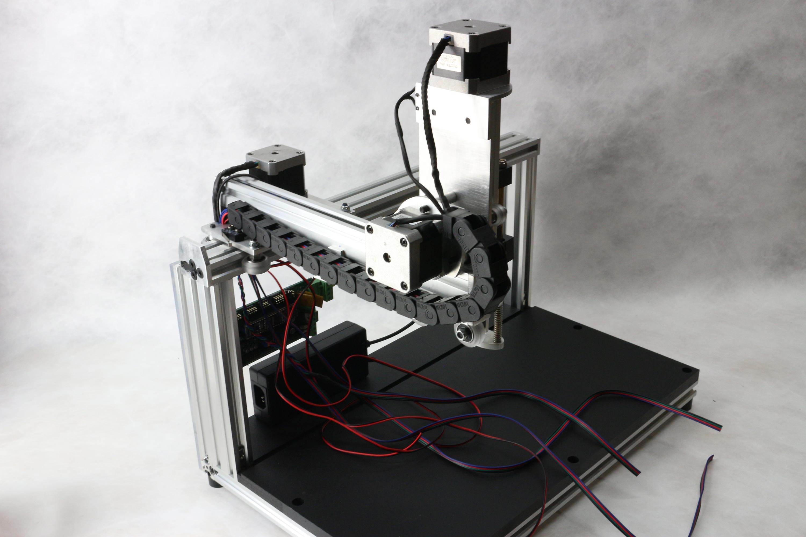
Assembly_instructions/images/y_cable_management.jpg
