north90/OpenSampler/Assembly_instructions/images/y_endstop_mounted.jpg

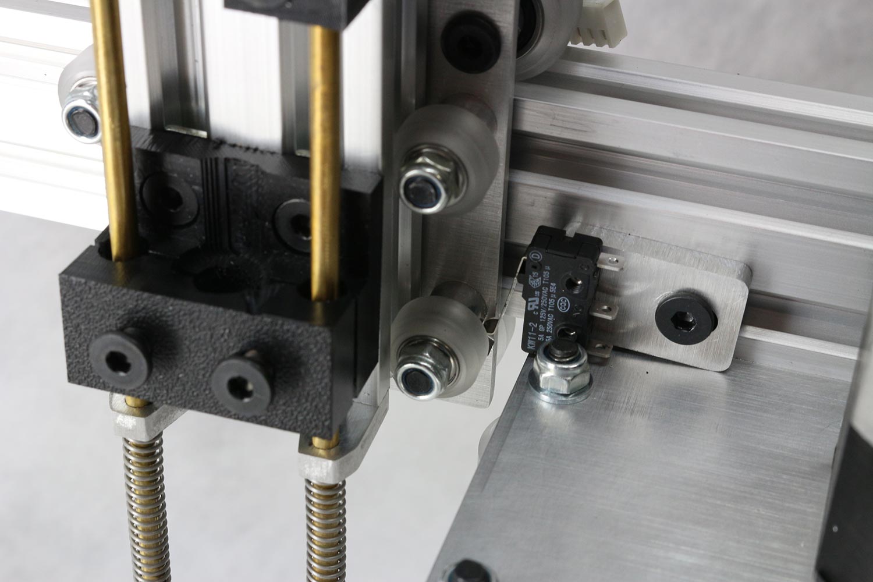
Assembly_instructions/images/y_endstop_mounted.jpg
