north90/OpenSampler/Assembly_instructions/images/y_plates.jpg

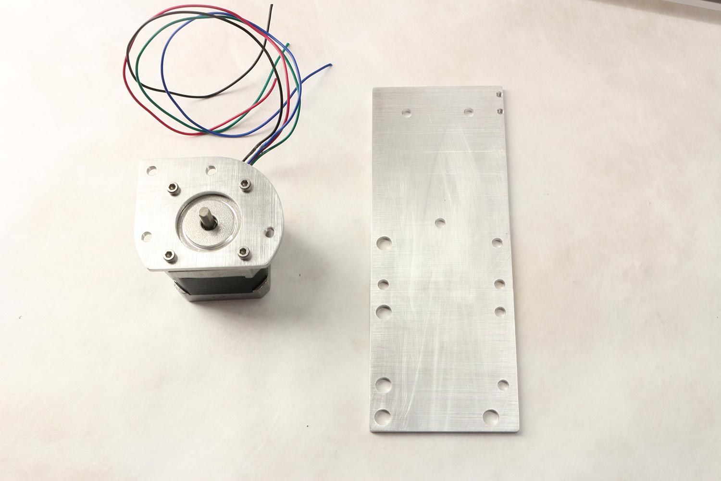
Assembly_instructions/images/y_plates.jpg
