north90/OpenSampler/Assembly_instructions/images/y_plates_3.jpg

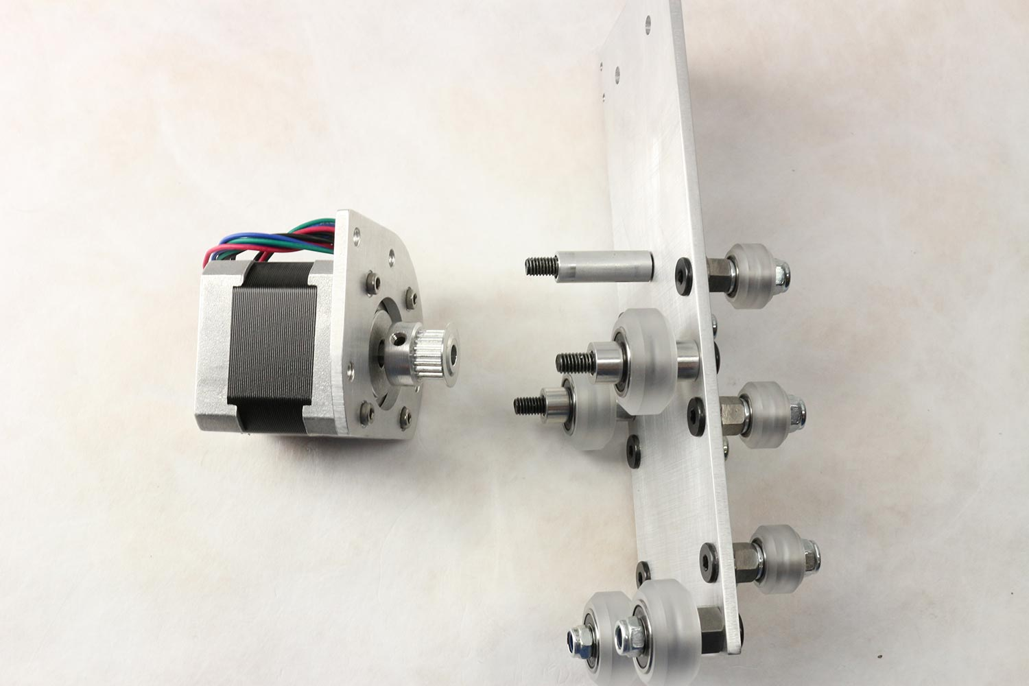
Assembly_instructions/images/y_plates_3.jpg
