north90/OpenSampler/Assembly_instructions/images/y_plates_4.jpg

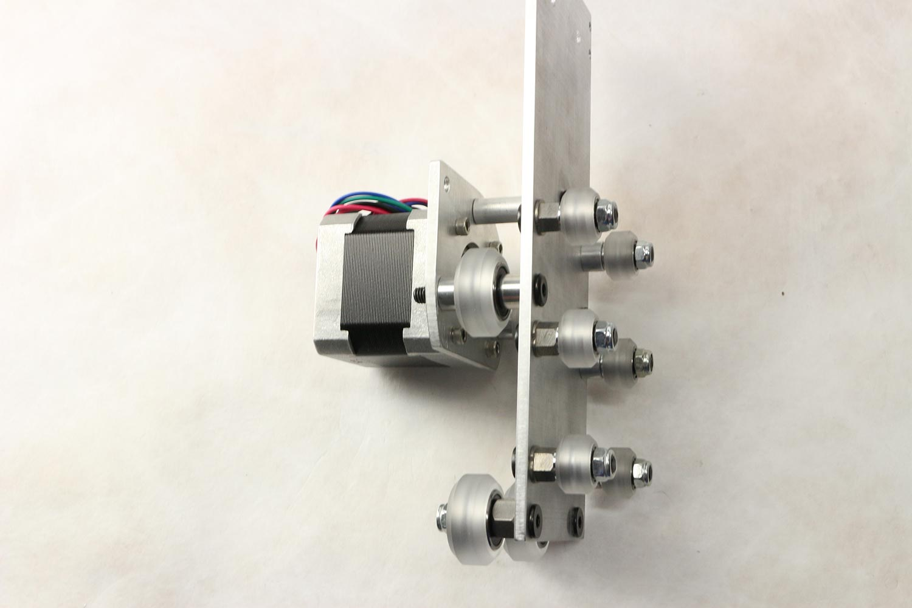
Assembly_instructions/images/y_plates_4.jpg
