north90/OpenSampler/Assembly_instructions/images/y_plates_5.jpg

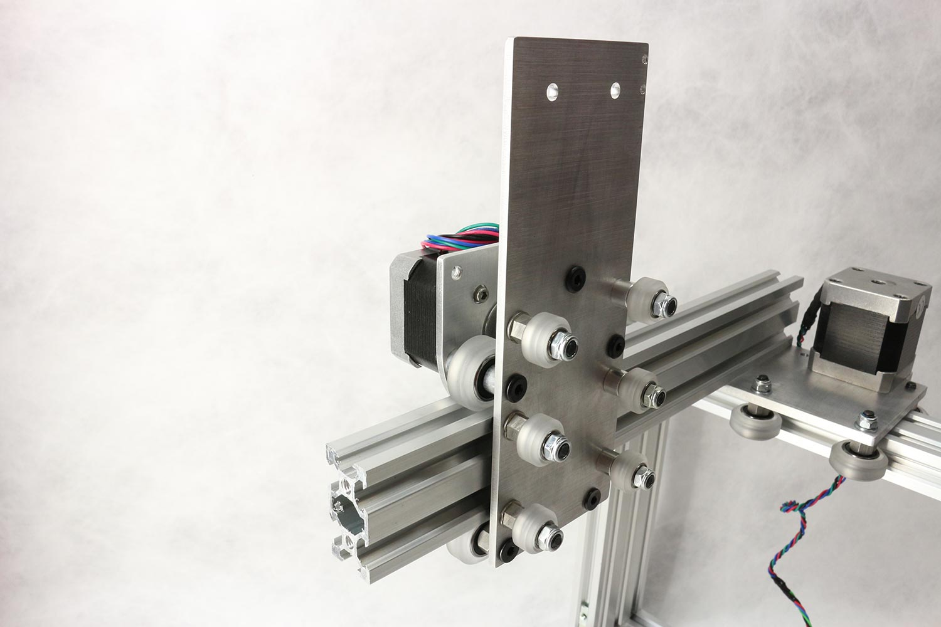
Assembly_instructions/images/y_plates_5.jpg
