north90/OpenSampler/Assembly_instructions/images/y_plates_6.jpg

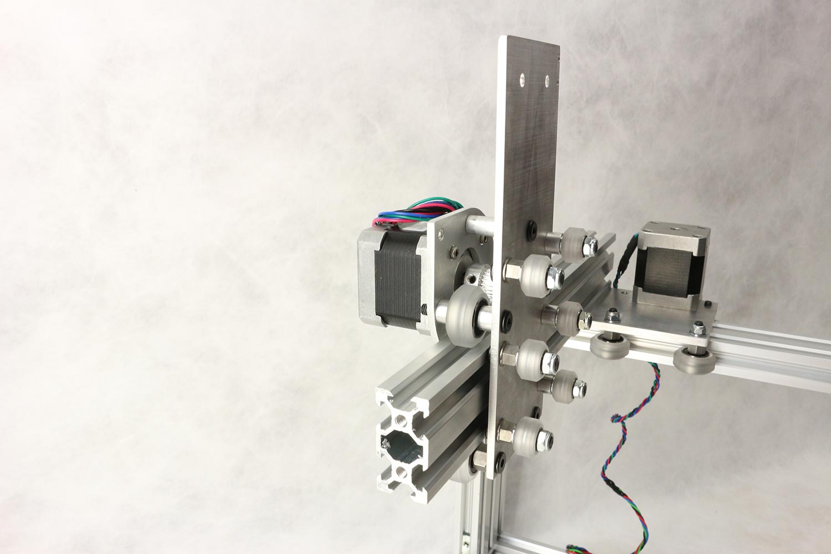
Assembly_instructions/images/y_plates_6.jpg
