north90/OpenSampler/Assembly_instructions/images/z_assembly.jpg

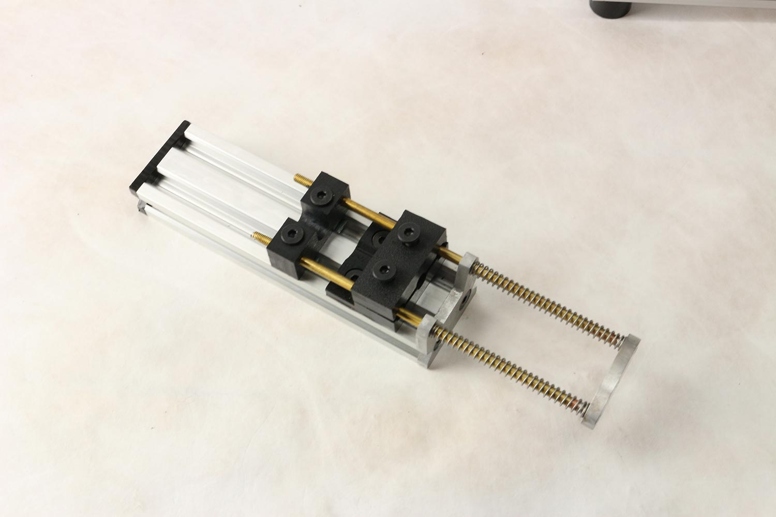
Assembly_instructions/images/z_assembly.jpg
