north90/OpenSampler/Assembly_instructions/images/z_endstop.jpg

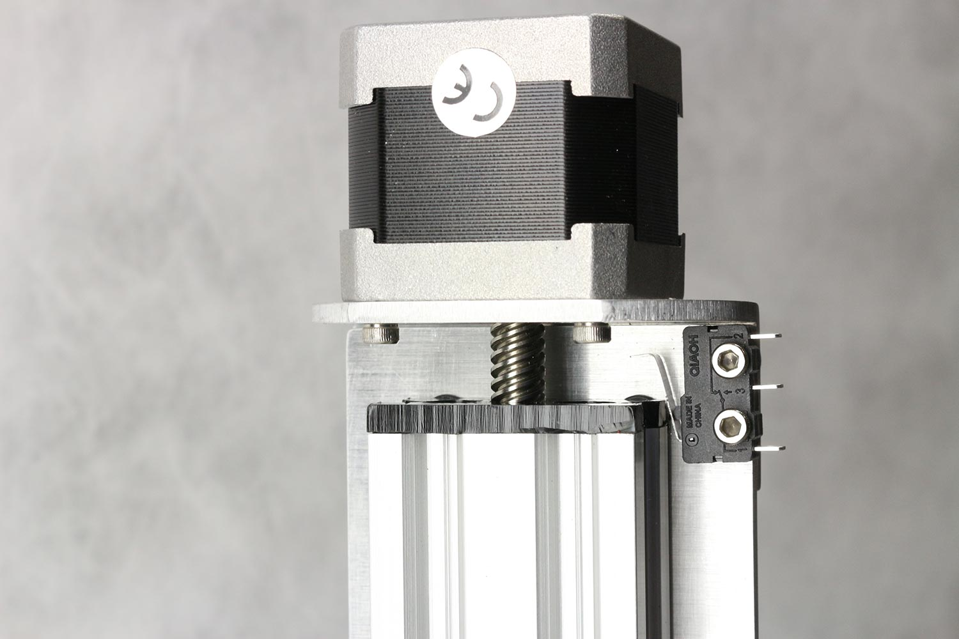
Assembly_instructions/images/z_endstop.jpg
