north90/OpenSampler/Assembly_instructions/images/z_motor1.jpg

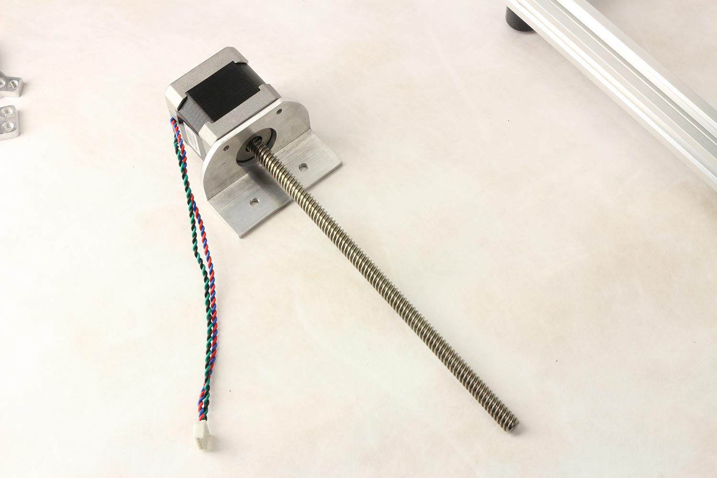
Assembly_instructions/images/z_motor1.jpg
