north90/OpenSampler/Assembly_instructions/images/z_motor2.jpg

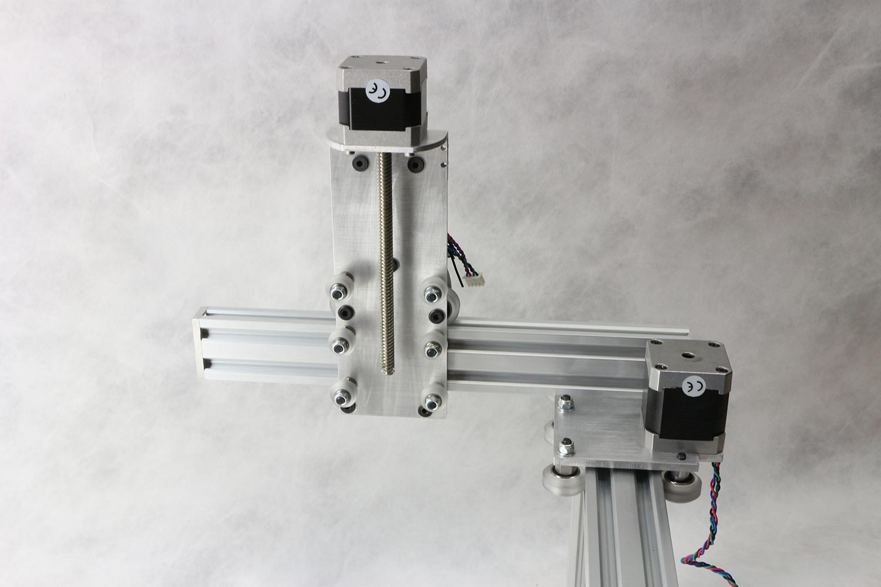
Assembly_instructions/images/z_motor2.jpg
