north90/OpenSampler/(threads)

Thread 1 (2024-11-04):

Arduino no longer manufactured

iblg, 2024-11-04:
Hello! I write with much admiration for the AutoSampler device, which seems extremely useful and flexible.

It appears that most of the parts are still available from the original suppliers, which is fantastic. However, the Arduino computers are no longer available.

I am interested in building an AutoSampler but have no robotics experience. Can you recommend a replacement for the RAMPS pre-assembled kit?
