north90/OpenSampler/Required_parts_and_sources/20150505_pololu_partlist.pdf

## - tt tttt t tt

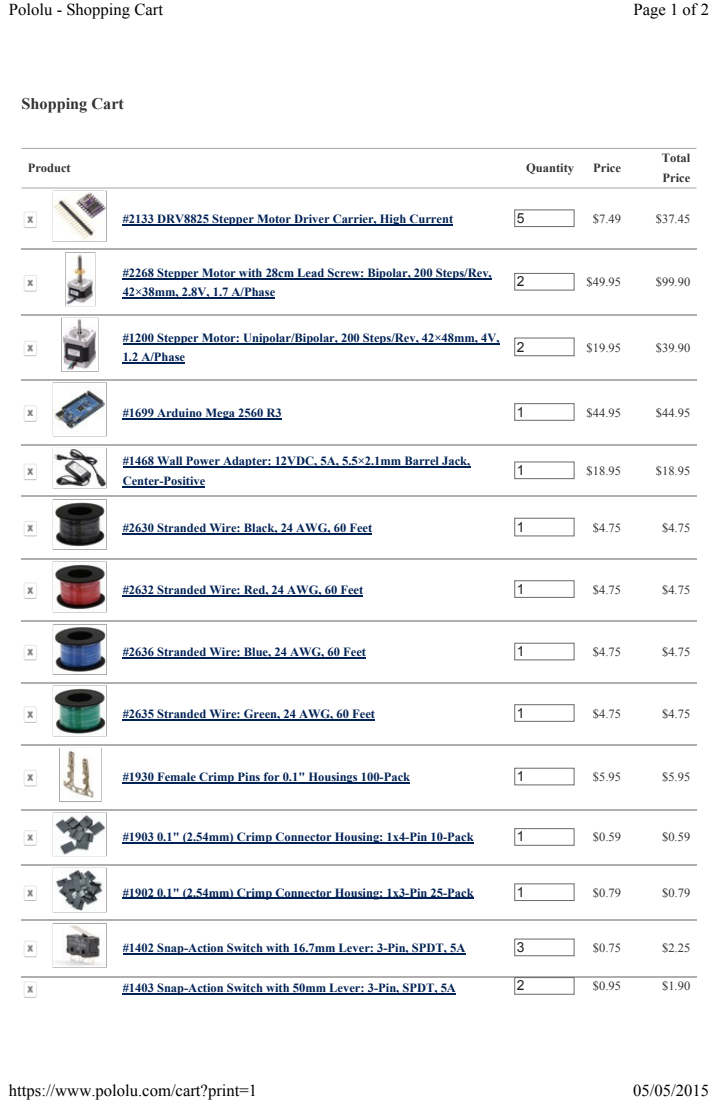
[picture p75: page 1]
t ttt; ttttt ttttttt; ttt t; ttt; tett; etett; t tettt tee e t; tett eteet; t ett; tet e t; tte t; e tttt t tet tetetet; tet; tee; e tett te e tt; tet te e tt; etk t t; tt3 t etk ktete; tkeet; tktet; ttet t; eet; ete tet t tt t te; tttt11//111 t; 1 1/1 tt1ttttt1

tl | 3tete t
. t t t 1t . 1 1t t . . ttt tt 1t 1. t tt 1 11
. | e | eee

t t t 1 . 1

## - tt tttt t tt

tttt11//111 t | 1 1/1 tt1ttttt1 | / /
