north90/OpenSampler/Required_parts_and_sources/20150505_ultimachine_partlist.pdf

# eeeeeeeeeee

# tettteetteete

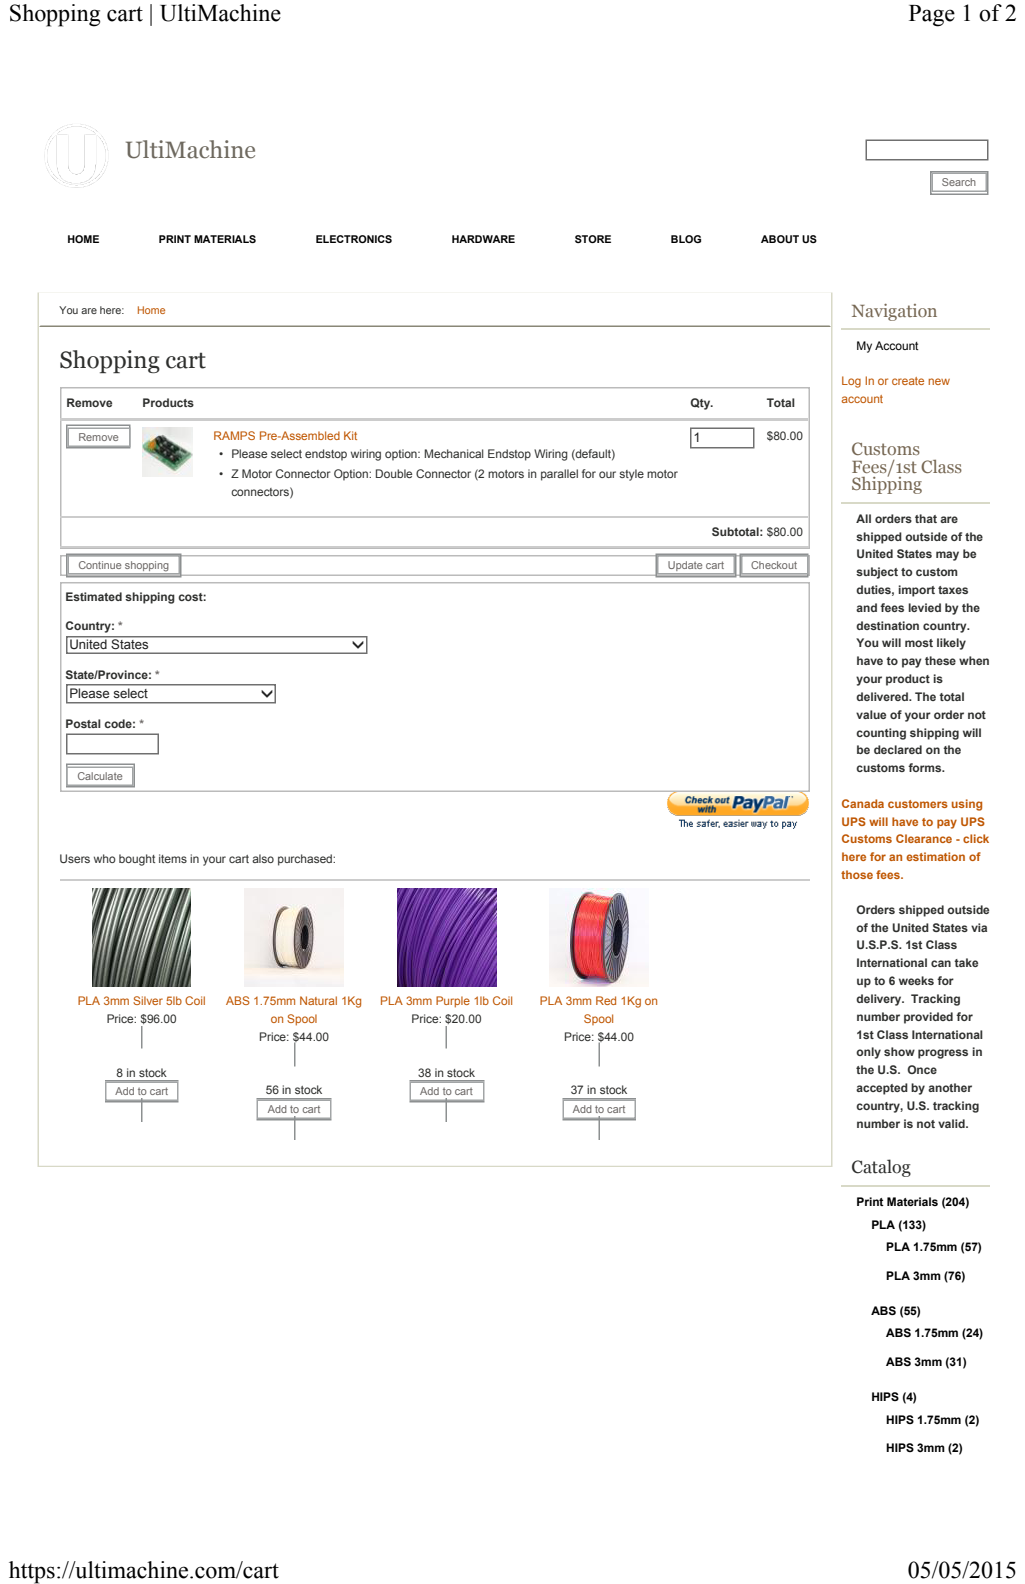
[picture p76: page 1]
hhhhhh; ttthththhht; thhhtttt; ttthhhthhhh t eteh; eeeeee; ssesssss; lesll; eheteh; ettthtthhtttthetthttttt; ttttthttt))hhttht tttt) t tttthttt))hhttht) tettthttt)tthhhtthtt)thttthttt thtetttht; :s:sesll:t000000; t)tthtthththt; tthhthtththht; sessll:sese::*; ththtthth; neneteeete; t tthhtt)t; t)t )tththhhhtht)h)t hhhtt)t; teetteet; eeeett; t ttleethttehhtlttttttt ththh t000000; 0tt)ttttht; ttttttthhht; t ht10 leet htthhtt1t)t t)thtttt ththh t000000; l0tt)ttttht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

tthhthtththhtth)tttttt)tht))tttttt) tthhhh)thhtt))tttttt)tht))t)th)httt)
ht))hhttht)

ll:essess:s:ls:lse:
s::::es:esss:se:e :s:e:
::ses::slses:el.::e:
ss: ess:se:ssssee:
sss:es ::e:ess:sl es:
l:s: ees:lee:es::.:s:e:
sess::ls:e::ses:ss..:
es: :ll:eess:l: el.:
:lee:se::l.:s:ese: :e::
.ess::sessss::s:
sel:eeses.:l:e:sesll:
ellse:e :.ess:esses::es:
ses:s::::s:::::::: :ll:
:e:sesllses:e::s:e:
ssssees: eses.

tt)tt)thtthtttt))

:ss:elses:s::::::::sess:

:slse ssee::se::*

l:lsl:sssseeess:ss::::
s:: :ll::lee:se::l.: s::
sssees: lelsl:se: :sl:s :
:ese: es:l::ess:els:e::e :
s:ese: ees.

tthhtt)httttt)htttthettt)t tththhhtthtttttthhhhtht

ssess:s::::es:esss:se:
e :s:e: ::ses::slses:e:l:
.:.s.:.: ss: llss:
:ses:ls:e:ll:sl::sl e:
sel:ees..::lsls ::::
:se:es::see:ses: es:
ss: llss: :ses:ls:e:ll:
e:l.:s:e ::se:sess::::
lsse:ses::.:l:es:es:
ses:ss. : .:.:ssls ::::
:se:es::s::es:ell:s.

ss::s:)lses:lls:)))))

ee eeee e ee e eeeee eeee | 2 | 2

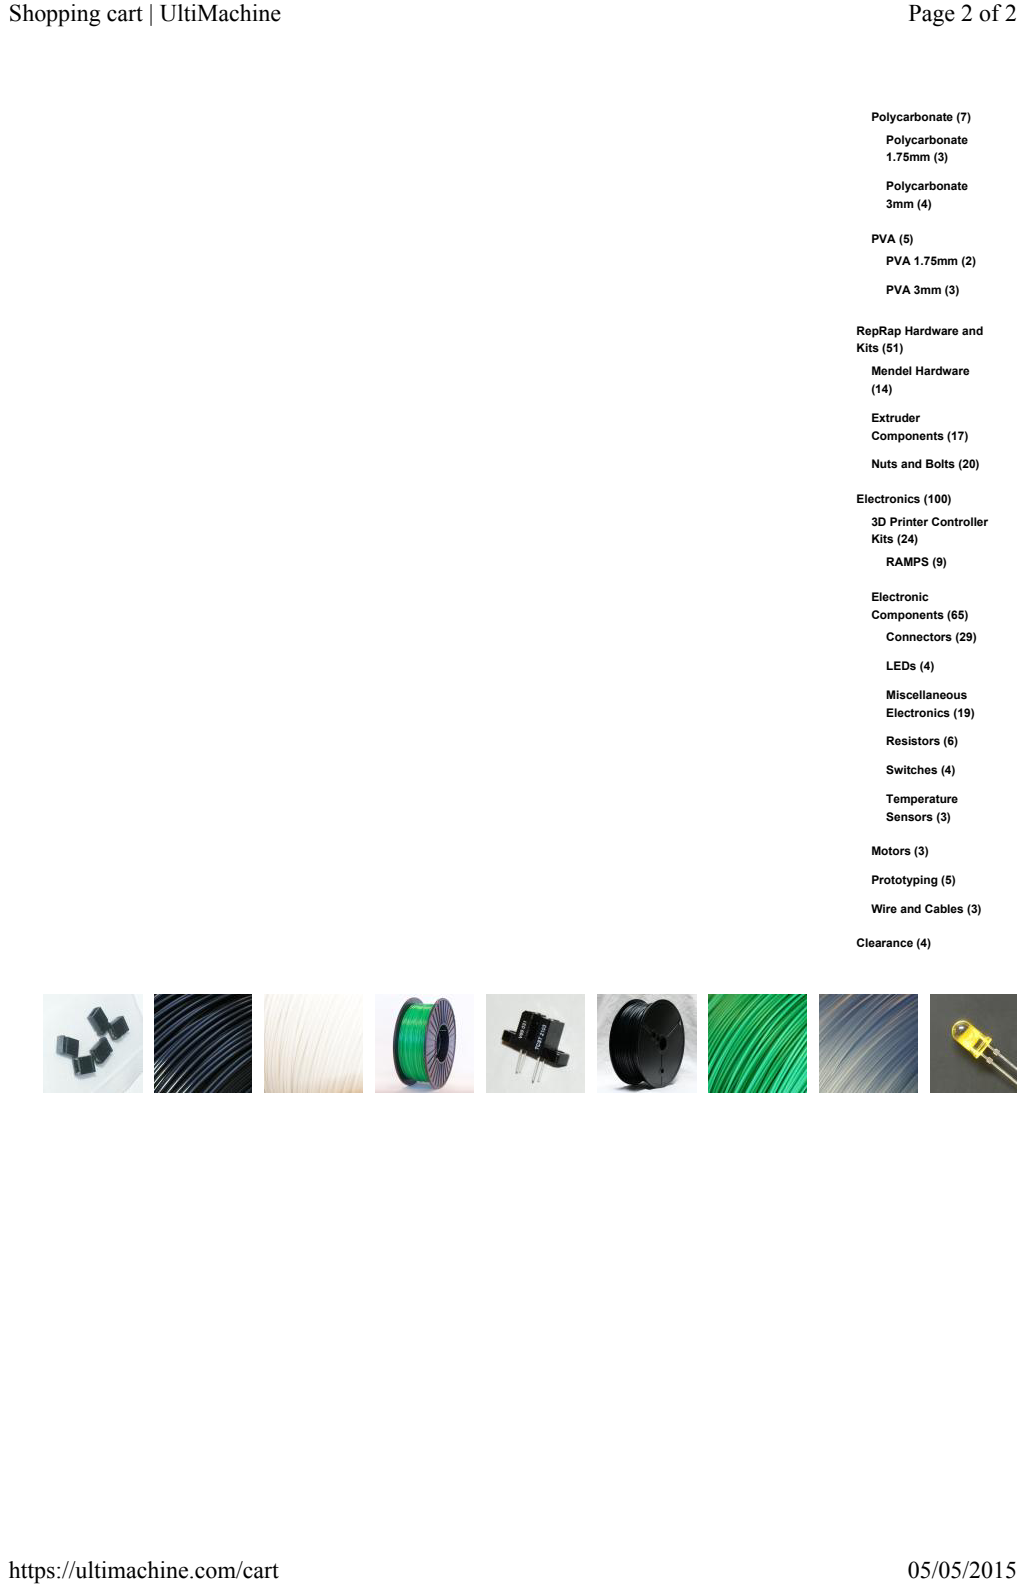
[picture p77: page 2]
: sssses:; Ssss:l:s:)elss:)))); :lessse::ss:) ))); :lessse::s:; e::essess:)))); ):sselll:eess:; :lessse::ss:) )); ees:ssess:) ); lee:eslssse:; :e:sess:))); )esess:))); sseses.:::::))); E:se:l:s: l:les:))); lelsl:se:))); eeeett//teeet eeee te t/e ee

sel.sls:e:lse:)))

sel.sls:e:lse:

ee:el::)lss lse:l:s:

)e:sel:)lss lse:

)E:ss::ses: e:sselles:
