north90/OpenSampler/(commit log)

2014-11-09 first upload
    [Configuration.h, OpenSampler_v3_v0p3.scad]
2015-07-29 updated all files for OpenSampler_V4
    Smaller, sleeker design, with loads of additional details in SCAD file
    [20150613_16mm_tube_tray_v0p0.scad, Configuration.h, OpenSampler_v3_v0p3.scad, OpenSampler_v4_PARTS_v0p1.scad, OpenSampler_v4_config_v0p0.scad, OpenSampler_v4_v0p2.scad, example.csv, sample_pos_calc_OpenSampler_V4.xlsx]
2015-07-29 deleted duplicate files
    [Configuration.h]
2015-07-29 updated control software to newest version
    [switcherlog.csv]
2015-11-22 Images for assembly OpenSampler V5
    details on assembly of OpenSampler V5
    [Configuration.h]
2015-11-22 updated assembly instructions
2017-06-14 Added and updated files
    [20141018_y_motor_plate.dxf, 20150602_frontplate.dxf, 20150608_y_plate_top.dxf, 20150608_z_motor_plate_side-cut.dxf, 20150608_z_motor_plate_top-cut.dxf, 20150609_needle_mount_bottom.stl, 20150609_needle_mount_top.stl, 20150609_spring_plate.dxf]
